GabrielBarbosaUFSC/Projeto-Pendular/AnaliseDados/Motor Torque/Motor Ref/- AliExpress_files/12V24VDC-Low-Speed-Long-Life-Super-Powerful-Torque-42mm-Planetary-Gearbox-Gears-775-Motor-Planet-Deceleration.jpg_220x220xz.jpg_.webp

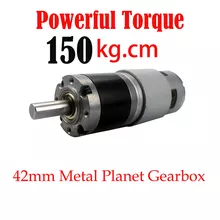
AnaliseDados/Motor Torque/Motor Ref/- AliExpress_files/12V24VDC-Low-Speed-Long-Life-Super-Powerful-Torque-42mm-Planetary-Gearbox-Gears-775-Motor-Planet-Deceleration.jpg_220x220xz.jpg_.webp
