GabrielBarbosaUFSC/Projeto-Pendular/AnaliseDados/Motor Torque/Motor Ref/- AliExpress_files/S8b12bd6959954953b04f11af4f3a7155e.jpg

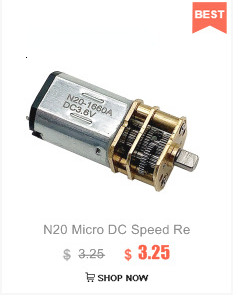
AnaliseDados/Motor Torque/Motor Ref/- AliExpress_files/S8b12bd6959954953b04f11af4f3a7155e.jpg
