GabrielBarbosaUFSC/Projeto-Pendular/AnaliseDados/MotorExp/Exp4/readme.txt

Objetivo: obter a constante de velocidade do motor, constante de torque e constante de atrito
