GabrielBarbosaUFSC/Projeto-Pendular/Trabalho_SNL_2023.pdf

# Análise da Dinâmica e Estratégia de Controle via Realimentação Linearizante para um Robô Autoequilibrado de Duas Rodas

Luan Diego Ramalho Arantes
Mestrado em Engenharia de Automação e Sistemas Sistemas Não Lineares
Florianópolis, Brasil
luandrarantes@gmail.com

Resumo—Robôs autoequilibrados de duas rodas são sistemas não lineares e naturalmente instáveis que demandam técnicas avançadas de controle para garantir sua estabilidade e rastreamento de trajetórias de forma eficaz. No contexto deste estudo, a dinâmica do robô foi cuidadosamente analisada para entender o comportamento de seus pontos de equilíbrio. Com base nessa análise, a modelagem e o controle do robô autoequilibrado foram detalhados. Utilizando a abordagem de linearização por realimentação, o sistema foi desacoplado e foram derivados subsistemas que foram posteriormente controlados. O principal objetivo era desenvolver controladores que permitissem um rastreamento eficaz de trajetórias, considerando trajetórias em formato de quadrado e círculo como estudos de caso. Através da técnica de regulador quadrático linear, os ganhos dos controladores foram otimizados para garantir um rastreamento preciso e uma resposta rápida. Os resultados simulados, comparando as trajetórias desejadas com as obtidas, confirmaram a eficácia dos controladores projetados.
Index Terms—Linearização por realimentação, Rastreamento de trajetória, Robô autoequilibrado
I. INTRODUÇÃO

O controle por realimentação, reconhecido como parte fundamental e intrínseca a uma gama de situações e a base da engenharia de controle de sistemas, este conceito é este presente em inúmeros sistemas dinâmicos, desde o equilíbrio e a locomoção de bípedes até a aterrissagem autônoma de foguetes. Embora os métodos de controle tradicionais sejam adequados para sistemas simples, sistemas mais complexos, como robôs com múltiplos eixos de movimento, plantas químicas complexas e redes elétricas avançadas, exigem abordagens mais sofisticadas. Estes sistemas apresentam desafios devido às suas complexas interações e aos impactos que um parâmetro pode ter em outro .
Os robôs autoequilibrados representam uma classe de sistemas complexos que operam sob o princípio de manter o equilíbrio enquanto realizam movimentos em superfícies variadas. Estes robôs, frequentemente equipados com duas rodas, empregam técnicas avançadas de controle para permanecerem eretos e navegarem em ambientes complexos. O estudo de tais sistemas é crucial, não apenas devido à sua relevância na pesquisa robótica atual, mas também devido às suas potenciais aplicações em áreas como transporte pessoal, logística e assistência a mobilidade.
Um dos desafios centrais na operação destes robôs é a necessidade de controladores precisos e robustos. O controlador deve garantir não apenas que o robô se mantenha equilibrado, mas também que seja capaz de seguir trajetórias predeterminadas em diferentes cenários. O seguimento de trajetória é uma habilidade vital para muitas aplicações práticas, permitindo que o robô execute tarefas de maneira autônoma e eficiente. Neste contexto, o presente trabalho visa desenvolver um controlador para um robô autoequilibrado de duas rodas, focando no seguimento de trajetória. O estudo aborda a modelagem do sistema, o desenvolvimento do controlador e a simulação de seu desempenho em duas diferentes trajetórias. As metodologias e resultados aqui apresentados oferecem uma perspectiva técnica e detalhada sobre os desafios e soluções associados ao controle de robôs autoequilibrados.

II. DESENVOLVIMENTO

Nesta seção, é abordada a modelagem detalhada do robô autoequilibrado, proporcionando uma base sólida para compreensão do sistema e seu comportamento. A representação em espaço de estados é utilizada como principal ferramenta para capturar a dinâmica intrínseca do robô. Em sequência, é realizado um estudo aprofundado da dinâmica do sistema, explorando os pontos de equilíbrio e o comportamento sob variações de parâmetros. Concluindo esta seção, o projeto do controlador é elaborado com base nas informações coletadas, visando um desempenho otimizado no seguimento de trajetórias.

A. Modelagem do Sistema
Um robô autoequilibrado é caracterizado por duas rodas acopladas a uma estrutura vertical, tendo seu comportamento análogo a um pêndulo invertido fixado a um carrinho. Dado o interesse em modelar o movimento do robô em duas dimensões (x e y), dois ângulos se tornam fundamentais para a descrição do sistema: o ângulo de inclinação θ, que representa o desvio da estrutura vertical em relação ao eixo z, e o ângulo de guinada α, que descreve a rotação do robô em torno do

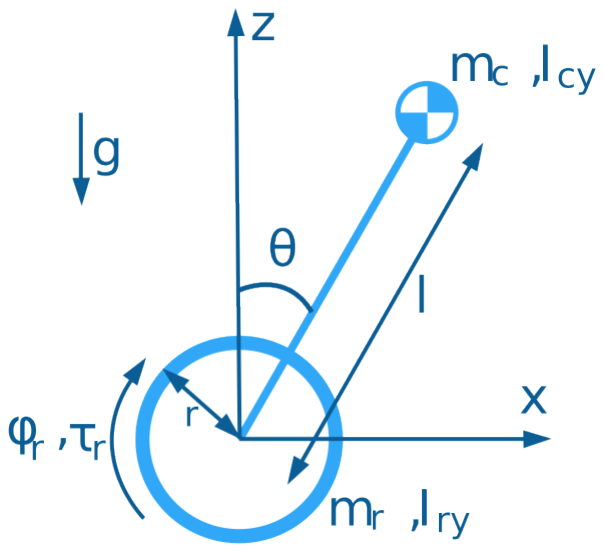
[picture p3: figure]
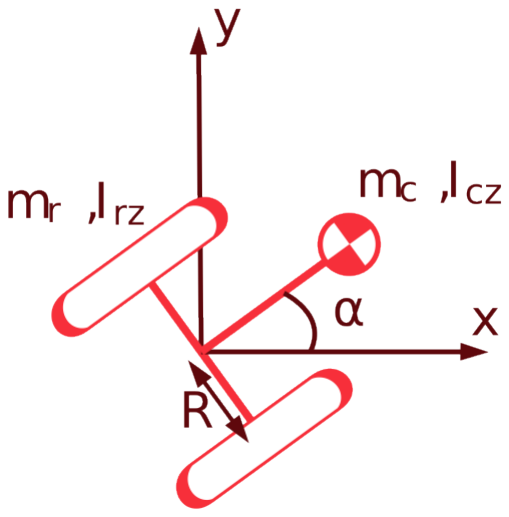
[picture p4: figure]

(a) Vista lateral. | (b) Vista superior.

Figura 1. Diagramas de corpo livre.

eixo z. A Figura 1a apresenta o diagrama de corpo livre do robô quando visto de lado (eixos x e z), enquanto a Figura 1b fornece uma perspectiva superior, mostrando o diagrama de corpo livre em relação aos eixos x e y.
As variáveis representadas nos diagramas têm os seguintes significados:
- mc: Massa do centro de massa do robô.
- mr: Massa da roda.
- Icy e Icz: Momentos de inércia do corpo em torno dos eixos y e z, respectivamente.
- Iry e Irz: Momentos de inércia da roda em torno dos eixos y e z, respectivamente.
- φr: Ângulo de rotação da roda.
- τr: Torque aplicado à roda.
- l: Distância entre o centro da roda e o centro de massa do robô.
- r: Raio da roda.
- R: Distância entre o centro do eixo do robô e a roda.
- g: Aceleração devido à gravidade.
A representação em espaço de estados para o sistema pode ser obtida utilizando as equações de Euler-Lagrange. Este método aproveita a análise da energia cinética e potencial do sistema para estabelecer as equações de movimento. A equação de Euler-Lagrange é dada por:

d

dt
∂L
∂q˙i
−

∂L
∂qi
= Qi | (1)

Onde qi representa as coordenadas generalizadas e Qi são as forças não conservativas. O Lagrangiano L é definido como a diferença entre a energia cinética T e a energia potencial U:

L = T − U | (2)

É importante destacar que neste sistema ocorrem perdas devido a fatores não ideais, como o atrito. A função de dissipação de Rayleigh é uma ferramenta que pode ser utilizada para incluir estas perdas nas equações de movimento. Esta função representa a perda de energia associada ao atrito proporcional à velocidade, neste caso, do atrito entre a roda e o solo. A expressão para essa função é:

F =

br
2

( ˙φ

2
r1 + ˙φ

2
r2
) | (3)

Onde br é o coeficiente de atrito viscoso e φ˙ r1 e φ˙ r2 são as velocidades angulares das rodas.
A equação de Euler-Lagrange modificada, que leva em conta a dissipação causada pelo atrito, torna-se:

d

dt
∂L
∂q˙i
−

∂L
∂qi

= Qi −

∂F
∂q˙i

(4)

O robô pode ser conceptualmente dividido em duas partes principais: o centro de massa e as rodas. As energias associadas a cada uma dessas partes são descritas por:
Centro de Massa:

Tc =

mcv

2
c
2

+

Icyθ

2
2

+

Iczα

2
2

(5)

Uc = mcgl cos(θ) | (6)

Rodas:

Tr =

mr(v

2
r1 + v

2
r2

)
2

+

Iry( ˙φ

2
r1 + ˙φ

2
r2

)
2

+ Irzα˙

2
(7)
Ur = 0 | (8)

Onde vc,vr1 e vr2 são as velocidades totais do centro de massa, da roda 1 e da roda 2 nos eixos x, y e z.
Considerando que não existe deslizamento, a relação entre a velocidade linear vri e a velocidade angular φ˙ i das rodas é dada por:
vri = rφ˙ i | com i = 1, 2 | (9)

A velocidade do corpo do robô vc pode ser reescrita em função da velocidade horizontal do corpo vxy e da velocidade vertical do corpo z˙c:

vc =

q
| v
| 2 xy + ˙z
| 2 c | (10)

Como o corpo está preso à roda logo:

vxy =

vr1 + vr2
2
| + l
| ˙θ cos θ | (11)

z˙c = −l

˙θ sin θ | (12)

Por se tratar de um robô com rotação diferencial:
α˙ = | vr2 − vr1
| 2R | (13)

Com base em (2) e nas equações de (5) a (13):

L = aφ˙

2
r + bφ˙

2
rm +

c
2

( ˙φ

2
r1 + ˙φ

2
r2

)

+ dφ˙ r

˙θ cos θ +

e
2

˙θ
2 − mcgl cos θ (14)

Com:

φr = φr1 + φr2 | φrm = φr2 − φr1

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
| Icz
2

+ Irz

c = mrr

2 + Iry | d = mcrl
| 2
e = 2mcl
2 + Icy | f = mcgl

As coordenadas generalizadas qi e suas respectivas forças Qi para o sistema são definidas como:

qi

: φr1, φr2, θ | (15)
Qi
: τr1, τr2, −(τr1 + τr2) | (16)

Considerando que as rodas são controlados por motores de corrente continua, o torque gerado pelas rodas pode ser expresso como:

τri = KVi − B

φ˙ ri − ˙θ
com i = 1, 2 (17)

Resolvendo a equação (4) para as coordenadas apresentadas em (15), resulta em:

∆

φ¨r1
φ¨r2
¨θ
- + A = Bu
V1
V2
(18)

∆ =

a | b | d cos(θ)
b | a | d cos(θ)
d cos(θ) d cos(θ) | c
- (19)

A =

(br + B) ˙φr1 − B ˙θ − d sin(θ)

˙θ
2
(br + B) ˙φr2 − B ˙θ − d sin(θ)

˙θ
2
2B ˙θ − B( ˙φr1 + ˙φr2) − e sin(θ)
- (20)

Bu =

K | 0
0 | K
−K −K
- (21)

Resultando no espaço de estados:

x˙ =

### 0 I

0 0
x +
0 0

### 0 Ω (x)

+
0
Ψ (x)
u (22)

Onde:

x =

φr1 | φr2 | θ φ˙ r1 | φ˙ r2

˙θ

⊺

Ω (x) = −∆⁻¹A
Ψ (x) = ∆⁻¹Bu

u =

V1 V2

⊺

Os parâmetros físicos do sistema foram determinados a partir de um modelo real, que pode ser visto em [6]. Estes valores foram obtidos combinando técnicas de medição direta com simulações para alcançar aproximações que se assemelham às características reais do objeto de estudo. A Tabela 1 apresenta estes parâmetros:

Par. | Valor | Par. | Valor
r | 0.04 m | R | 0.18 m
Icz | 2.567 · 10⁻³ kg · m² | mc | 1.013 kg
mr | 0.07 kg | Iry | 7.103 · 10⁻⁵ kg · m²
Irz | 4.256 · 10⁻⁵ kg · m² | l | 0.09 m
Icy | 1.866 · 10⁻² kg · m² | g | 9.806 m/s²
br | 0.03 kg · m²/s | B | 0.05573
K | 0.2109
Tabela I
PARÂMETROS FÍSICOS DO SISTEMA.
B. Estudo da Dinâmica do Sistema
Com a equação de movimento do sistema já derivada, o próximo passo consiste em analisar seu comportamento dinâmico. Nesta subseção, focaremos inicialmente na análise dos pontos de equilíbrio do sistema. Posteriormente, estudaremos como o sistema responde às variações na ação de controle e no coeficiente de atrito.
Dado que as equações do sistema são independentes do ângulo da roda e dependem apenas da velocidade da roda, a análise pode se concentrar em situações onde a velocidade da roda não é nula. Resolvendo a equação (18) para condições onde as acelerações φ¨r1, φ¨r2,

¨θ e a velocidade ˙θ são nulas e com tensões nos motores constantes, obtemos:

φ˙ r1 = −

KV1
B + br

(23)

φ˙ r2 = −

KV2
B + br

(24)

θ = arcsin
K
e

(V1 + V2)

1 −

B
B + br

(25)

A partir das propriedades da função arcoseno, deduzimos as seguintes possibilidades para os equilíbrios:
- Se V1 +V2 = 0, o sistema possui apenas dois equilíbrios, onde ¯θ ∈ {0, π}.
- Se V1 + V2 = ±

e
K(1− B
B+br

)

, o sistema possui um único equilíbrio em ¯θ ∈ {±π
2

}.
- Para 0 < |V1+V2| <

e
K(1− B
B+br

)

, existem dois equilíbrios para ¯θ em dois ângulos complementares dependentes de V1 + V2.
- Se |V1 + V2| >

e
K(1− B
B+br

)

, o sistema não possui pontos de equilíbrio.
A complexidade do sistema dificulta a análise algébrica da estabilidade dos seus pontos de equilíbrio. No entanto, ao empregar ferramentas computacionais como MATLAB e XPPAUT, conclui-se que os pontos de equilíbrio em −

π
2 ≤
¯θ ≤
π
2

são estáveis, enquanto os pontos em −

π

2 < ¯θ < π
2
são instáveis. É crucial ressaltar que, no contexto real do sistema, ângulos maiores que π
2

ou menores que −

π
2

não
são fisicamente possíveis, implicando que todos os pontos de equilíbrios fisicamente possíveis são instáveis.
A fim de aprofundar a compreensão sobre a dinâmica do sistema e como os pontos de equilíbrio são influenciados por determinados parâmetros, foram gerados gráficos de bifurcação utilizando a ferramenta XPPAUT. Os parâmetros escolhidos para essa análise, o coeficiente de atrito br e as tensões no motor, foram selecionados devido à possibilidade de variação destes durante a operação do robô.
O impacto nos pontos de equilíbrio não é determinado isoladamente pelos valores das tensões, mas pela soma delas. Portanto, o foco dessa seção será a variação do V1 e do br, já que a variação de V2 gera o mesmo resultado. A Figura 2a ilustra a evolução dos pontos de equilíbrio conforme V1 aumenta para diferentes valores de br, enquanto a Figura 2b mostra como os pontos de equilíbrio evoluem à medida que

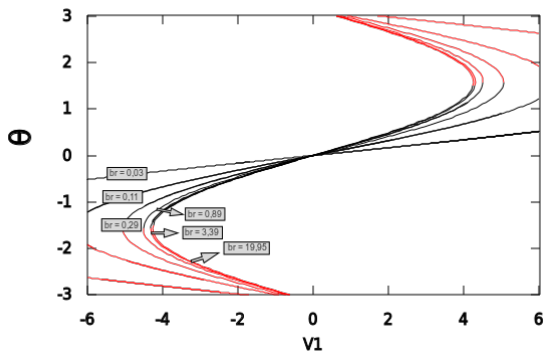
[picture p5: figure]

(a) θ em função de V1.

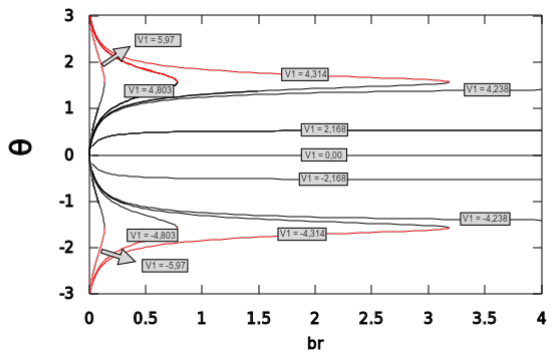
[picture p6: figure]

(b) θ em função de br.

Figura 2. Diagramas de Bifurcação. As linhas pretas e vermelhas simbolizam respectivamente que o ponto de equilíbrio é instável ou estavel.

br aumenta para vários valores de V1. A faixa de estudo para as tensões foi estabelecida entre −6V e 6V , considerando que esses são os limites fornecidos pelo motor utilizado no sistema real.
Ao analisar os gráficos, observa-se que à medida que o valor de br aumenta, a região contendo os pontos de equilíbrio diminui. Esta tendência é resultado da expressão 1 −

B
B+br
presente em (25). No entanto, existe um ponto de saturação para essa relação: quando br tende ao infinito, ¯θ converge para arcsin K
e

(V1 + V2)

C. Projeto do Controlador
Após uma análise minuciosa e entendimento do comportamento do sistema, a próxima etapa é formular uma lei de controle adequada, denotada por u, para o sistema em questão. Esta seção visa detalhar o processo de criação e desenvolvimento do controlador.
O principal intuito deste projeto de controle é desenvolver uma lei que possibilite ao sistema seguir uma trajetória específica. Em outras palavras, o sistema deve ser capaz de rastrear referências para os ângulos das rodas. Contudo, dada a natureza intrinsecamente instável do sistema, o controle também deve assegurar a estabilidade do ângulo θ, buscando minimizar ao máximo suas variações. Com esse objetivo em vista, optou-se pelo uso da técnica de linearização por realimentação, o que viabiliza o desacoplamento do sistema e sua análise em partes separadas. É relevante mencionar, no entanto, que devido à subatuação do sistema, apenas uma linearização parcial é praticável.
Primeiramente, realizou-se uma mudança de variáveis, uma vez que, na configuração atual do sistema, não é possível realizar o seu desacoplamento por meio da linearização por realimentação, isto é devido ao angulo de inclinação θ depender de ambas as velocidades angulares φ˙ ri. As novas variáveis definidas foram:
φr1 = φr − φrm | (26)
φr2 = φr + φrm | (27)

Esta transformação de variáveis conduziu a um novo espaço de estados representado por:

x˙ n =

### 0 I

0 0
xn +
0 0

### 0 Ωn (xn)

+
0
Ψn (xn)
u (28)

Onde:

xn =

φr | φrm | θ φ˙ r | φ˙ rm

˙θ

⊺

Ωn (x) = −∆⁻¹
n An
Ψn (x) = ∆⁻¹
| n Bu
u =
V1 V2

⊺

∆n =

(a + b)/2 (b − a)/2 d cos(θ) (a + b)/2 (b − a)/2 d cos(θ)
d cos(θ) | 0 | c

An =

(br + B)( ˙φr − φ˙ rm) − B ˙θ − d sin(θ)

˙θ
2
(br + B)( ˙φr + ˙φrm) − B ˙θ − d sin(θ)

˙θ
2
2B ˙θ − Bφ˙ r − e sin(θ)

Se segmentarmos o sistema em partes atuadas x2 e não atuadas x1, obtemos:

x˙ 1 = x2 | (29)
x˙ 2 = Ωn (x) + Ψn (x)u | (30)

O vetor x2 engloba φ˙ r e φ˙ rm. O objetivo da linearização é que o sistema resultante seja representado por:

φ¨r = v1 | (31)
φ¨rm = v2 | (32)

Para atingir este objetivo, podemos decompor x˙ 2 da seguinte forma:
φ¨r

φ¨rm
= Ωn1 (x) + Ψn1 (x)u | (33)
¨θ = Ωn2 (x) + Ψn2 (x)u | (34)

Onde Ωn1 e Ωn2 são submatrizes de Ωn, e Ψn1 e Ψn2 são submatrizes de Ψn.
Ao igualar -

φ¨r φ¨rm⊺
a
v1 v2

⊺
, obtemos a ação de
controle linearizante para o sistema:

u = Ψ⁻¹
n1

(x)

v1
v2
− Ωn1 (x)
(35)

Ao implementar esta ação de controle no sistema, resultamos em dois sistemas desacoplados. O primeiro é descrito por:

y˙1 =

φ˙ r
˙θ
v1
L + Mv1

(36)

Onde

L =

2d sin(θ)

˙θ
2 − brφ˙ r + e sin(θ)
c + 2d cos(θ)

M = −

a + b + d cos(θ)
c + 2d cos(θ)

O segundo sistema é descrito por:

y˙2 =

φ˙ rm
v2
(37)

O primeiro sistema foi parcialmente linearizado, de forma que o comportamento do sistema ainda é dependente dos estados θ e

˙θ. Analisando os pontos de equilíbrio, é observado um comportamento similar ao do sistema completo. Fazendo as mesmas considerações de que o ângulo da roda não influencia diretamente no sistema, obtemos um ponto de equilíbrio localizado em:

y¯1 =

φr
φ˙ r
arcsin brφ˙ r
0

(38)

Sendo que todos os pontos de equilíbrio com −π/2 < θ < π/2 são instáveis. Portanto, ainda é necessário projetar outra forma de controle para estabilizar o sistema. No entanto, observe que a linearização por realimentação reduz significativamente a complexidade do sistema, e que o segundo sistema está completamente desacoplado.
Para projetar o controlador, o sistema é linearizado no ponto de equilíbrio y¯1 = [0, 0, 0, 0]⊺
, pois o objetivo é fazer com que o robô siga uma trajetória de um ponto a outro, mantendo o ângulo θ com a mínima variação possível. O sistema resultante é:
y˙1 = A1y1 + B1v1 | (39)

A2 =

0 | 0 | 1 | 0
0 | 0 | 0 | 1
0 | 0 | 0 | 0
0 | e
c+2d | −
| | br c+2d | 0

(40)

B2 =

0
0
1
−

a+b+d
c+2d

(41)

Devido à ausência de um integrador no sistema, ele apresentará erro em estado permanente para o ângulo φm. Para corrigir isso, um integrador é incluído no sistema:

˙ζ1 = (ref1 − φr). | (42)

A lei de controle v1 foi então definida como:

v1 = Kc1

ref1 − φr
−θ
˙ref1 − φ˙ r
− ˙θ
ζ1

(43)

A determinação do ganho Kc1 foi realizada utilizando a técnica ótima do regulador quadrático linear, definindo as matrizes Q e R como:

Q = diag (100, 0, 0, 0, 10) | (44)
R = 0.001. | (45)

O objetivo foi dar máxima prioridade ao controle do posicionamento do robô, buscando uma resposta rápida que mantenha o sistema estável.
Para o segundo sistema, o controle foi estabelecido através da dinâmica do erro. A dinâmica do erro é dada por:

e˙2 = A2e2 + B2(ref ¨
2 − v2) | (46)

Onde:

A2 =

0 1

0 0
B2 =
0
1

e2 =

ref2 − φrm

˙ref2 − φ˙ rm⊺

Mais uma vez, para assegurar um erro nulo em regime permanente, um integrador foi acrescentado. Isso resultou na seguinte lei de controle:

v2 = ref ¨
2 + Kc2
e2
ζ2
(47)

A determinação do ganho Kc2 foi realizada também empregando o regulador quadrático linear. As matrizes Q e R foram definidas da seguinte forma:

Q = diag (10, 0, 10) | (48)
R = 0.001 | (49)

O foco principal, mais uma vez, foi assegurar um desempenho otimizado para o erro de posicionamento em relação à referência
Com o controlador agora estabelecido e definido, a próxima seção se dedica a apresentar e discutir os resultados obtidos quando este controle é aplicado ao sistema para buscando o seguimento de trajetória, oferecendo uma visão concreta de sua eficácia.

III. RESULTADOS

Nesta seção, serão apresentados e discutidos os resultados obtidos com a aplicação dos controladores desenvolvidos no sistema em estudo. O foco está no desempenho do sistema em seguir trajetórias específicas de um ponto a outro no plano x − y.
Para realizar o seguimento de trajetória é crucial compreender as equações de cinemática inversa associadas ao robô de duas rodas. As relações entre as posições x e y, o ângulo de guinada α, e os estados do sistema são dados por:

x˙ =

r cos(θ) ˙φr
2

(50)

y˙ =

r sin(θ) ˙φr
2

(51)

α˙ =

rφ˙ rm
2R

(52)

Através delas é possível derivar as equações para a cinemática inversa:

φ˙ r =

2 ˙x
r cos(θ)

=

2 ˙y
r sin(θ)

(53)

φ˙ rm =

2Rα˙
r

(54)

É importante notar que quando sin(θ) = 0, a equação em função de y˙ não pode ser aplicada. Similarmente, para cos(θ) = 0, a equação em função de x˙ é inválida. Utilizando a cinemática inversa é possível, mediante uma dada trajetória no eixo x−y, determinar a referência para os estados do sistema. Para o rastreamento da trajetória entre dois pontos foi utilizado a representação por um polinômio de terceiro grau:

xref = x0 +

3
t

2
f

(xf − x0)t

2 −

2
t

3
f

(xf − x0)t

3
(55)

Onde xref representa a referência, x0 o ponto inicial, xf o ponto final, e tf o tempo de deslocamento. Cada referencial de posição (x,y e α) são representados por um polinômio neste formato.
Utilizando o Simulink foi desenvolvido uma simulação compreensiva do sistema. Essa simulação engloba a planta não linear, um gerador de trajetória, o cálculo das ações de controle v1 e v2, e da realimentação linearizante.
Na validação do controlador proposto, duas trajetórias paradigmáticas foram escolhidas: uma em formato de quadrado e outra em formato circular. A escolha dessas trajetórias se dá pela sua capacidade de, conjuntamente, testar diversas facetas do desempenho do robô e do controlador em situações distintas.
Estas trajetórias foram geradas através do polinômio de terceiro grau mencionado anteriormente. Em cada caso, foram definidos pontos-chave para guiar o robô através da trajetória desejada, aproveitando o gerador de trajetória desenvolvido no Simulink.
A. Trajetória em Formato de Quadrado
A Figura 3 apresenta uma comparação entre a trajetória de referência, que era esperada, e a trajetória efetivamente obtida durante a simulação. Fica claro que existem pequenas variações durante o trajeto, entretanto o robô consegue seguir a referência e chegar até o ponto desejado.
A Figura 4 se concentra nos estados do sistema. Através dela, pode-se observar que o estado desacoplado durante a linearização por realimentação apresenta erro praticamente nulo durante toda a trajetória, enquanto o restante apresenta pequenas variações, mas alcançam a referência de forma satisfatória com pequenas variações no ângulo θ.

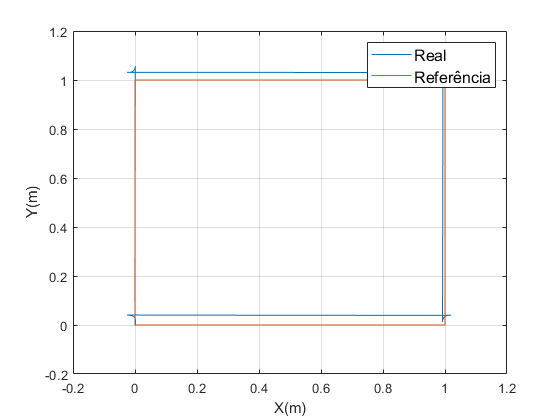
[picture p7: figure]

Figura 3. Comparação entre a trajetória de referência e o resultado da simulação para o formato quadrado.

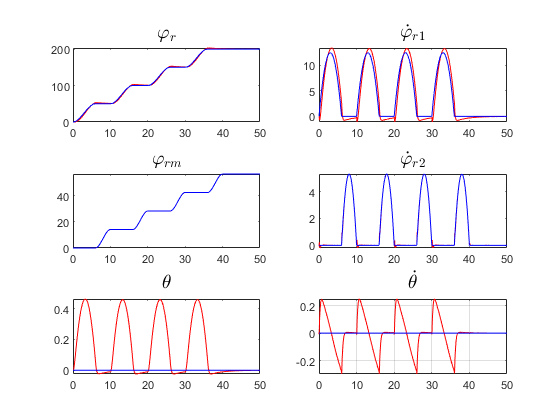
[picture p8: figure]

Figura 4. Estados do sistema para a trajetória em quadrado. Onde as linhas azuis e vermelhas simbolizam o resultado simulado e a referência.

B. Trajetória em Formato de Círculo
A Figura 5 compara a trajetória de referência com a trajetória efetivamente obtida durante a simulação para o círculo. Perceba que como o seguimento é feito de ponto a ponto, a referência tem um formato de hexágono que acaba resultando em um círculo.
A Figura 6 se aprofunda na análise dos estados do sistema. Nela, observa-se a evolução dos estados do robô ao longo da sua movimentação circular, e a comparação destes com suas respectivas referências dá uma visão clara sobre a eficiência do controlador, reafirmando os resultados obtidos com a trajetória quadrada.

IV. CONCLUSÃO
Ao longo deste estudo, foi realizada uma análise profunda da modelagem, controle e simulação de um robô autoequilibrado de duas rodas, ilustrando a importância da precisão em

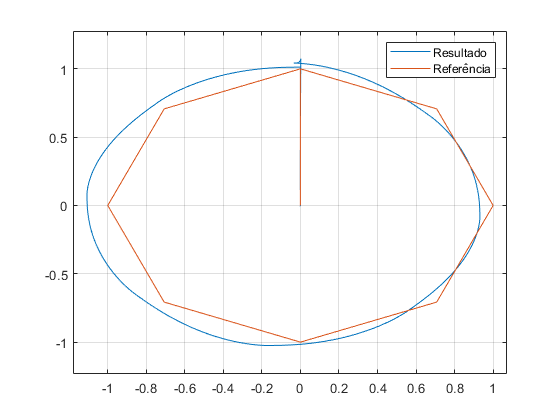
[picture p9: figure]

Figura 5. Comparação entre a trajetória de referência e o resultado da simulação para o formato circular.

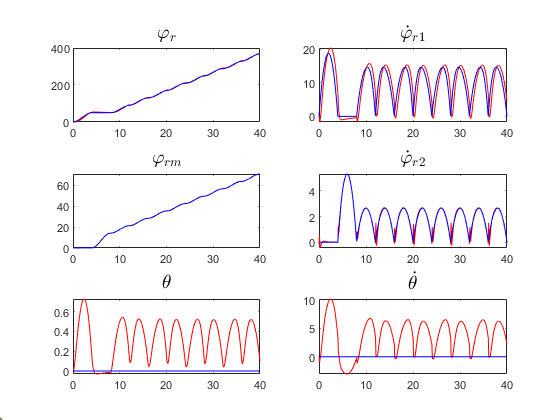
[picture p10: figure]

Figura 6. Estados do sistema para a trajetória em círculo. Onde as linhas azuis e vermelhas simbolizam o resultado simulado e a referência.

cada etapa do processo. O controle realimentado linearizante demonstrou ser uma abordagem eficaz na estabilização do sistema e no seguimento de trajetórias predeterminadas, mesmo em situações de complexidade, como trajetórias em formas de quadrado e círculo.
A modelagem inicial, que contou com parâmetros físicos extraídos de um modelo real, estabeleceu uma base sólida para o desenvolvimento subsequente. As trajetórias de referência, alinhadas com as equações de cinemática inversa, forneceram um roteiro para o deslocamento desejado do robô. Os resultados das simulações, ao serem comparados com as trajetórias de referência, evidenciaram o desempenho do controle implementado.
No entanto, é importante destacar que, embora os resultados tenham sido promissores, sistemas reais podem apresentar variações devido a ruídos, desgastes e outras perturbações não consideradas neste estudo. Portanto, testes em um ambiente real e ajustes contínuos do controlador podem ser necessários para otimizar ainda mais o desempenho do robô. Concluindo, este estudo representa um passo significativo na compreensão e controle de robôs de duas rodas. A abordagem adotada pode servir como um modelo para futuras investigações e implementações em sistemas robóticos similares.

REFERÊNCIAS

[1] B. Friedland, Control system design: an introduction to state-space methods. New York: Courier Corporation, 2012.
[2] G.F. Franklin et al, Feedback control of dynamic systems, 7th ed. Harlow: Pearson Education Limited, 2015.
[3] N.S. Nise, Control systems engineering, 7th ed. Pomona: John Wiley & Sons, 2015.
[4] R.C. Bishop and R.H. Dorf, Modern control systems, 14th ed. Harlow: Pearson Education Limited, 2022.
[5] K. Ogata, Modern Control Engineering, 5th ed. Upper Saddle River: Prentice Hall, 2010.
[6] L. D. R. Arantes and J. C. B. Dalcin, "Implementação de controle de realimentação de estados ótimo com observador de ordem mínima em um robô auto-equilibrado,"B.S. Thesis, Instituto Federal Catarinense, São Bento do Sul, Brazil, 2022. https://pergamumweb.ifc.edu.br/pergamumweb_ifc/vinculos/000026/00002628.pdf. (Accessed: Jun. 20, 2023).
[7] I. Gandarilla, J. Montoya-Cháirez, V. Santibáñez, C. Aguilar-Avelar, and
J. Moreno-Valenzuela, “Trajectory tracking control of a self-balancing robot via adaptive neural networks,” Engineering Science and Technology, an International Journal, vol. 35, pp. 101259, 2022.
[8] R. C. Ooi, “Balancing a two-wheeled autonomous robot,” B.S. Thesis, Faculty of Eng. & Math. Sciences, Univ. of Western Australia, Perth, Nedlands, 2003.
[9] K. Peng, X. Ruan, and G. Zuo, “Dynamic model and balancing control for two-wheeled self-balancing mobile robot on the slopes,” in Proceedings of the 10th World Congress on Intelligent Control and Automation, 2012, pp. 3681-3685.
[10] H. -S. Juang and K. -Y. Lum, "Design and control of a two-wheel self-balancing robot using the arduino microcontroller board,"2013 10th IEEE International Conference on Control and Automation (ICCA), Hangzhou, China, 2013, pp. 634-639, doi: 10.1109/ICCA.2013.6565146.
[11] A. Wasif, D. Raza, W. Rasheed, Z. Farooq and S. Q. Ali, "Design and implementation of a two wheel self balancing robot with a two level adaptive control,"Eighth International Conference on Digital Information Management (ICDIM 2013), Islamabad, Pakistan, 2013, pp. 187-193, doi: 10.1109/ICDIM.2013.6694021.
