GabrielBarbosaUFSC/Projeto-Pendular/AnaliseDados/Motor Torque/Motor Ref/- AliExpress_files/32GP-31ZY-Miniature-Planetary-Reducer-Diameter-DC-12V-24V-Reducer-Motor-Low-Speed-Speed-Regulation-Large.jpg_220x220xz.jpg_.webp

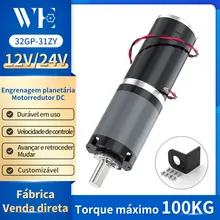
AnaliseDados/Motor Torque/Motor Ref/- AliExpress_files/32GP-31ZY-Miniature-Planetary-Reducer-Diameter-DC-12V-24V-Reducer-Motor-Low-Speed-Speed-Regulation-Large.jpg_220x220xz.jpg_.webp
