GabrielBarbosaUFSC/Projeto-Pendular/AnaliseDados/Motor Torque/Motor Ref/- AliExpress_files/38-tubular-motor-with-mounting-bracket-12V-24V-DC-motor-mounting-bracket.jpg_220x220xz.jpg_.webp

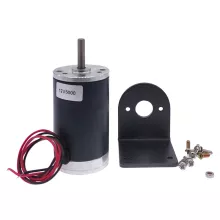
AnaliseDados/Motor Torque/Motor Ref/- AliExpress_files/38-tubular-motor-with-mounting-bracket-12V-24V-DC-motor-mounting-bracket.jpg_220x220xz.jpg_.webp
