GabrielBarbosaUFSC/Projeto-Pendular/AnaliseDados/Motor Torque/Motor Ref/- AliExpress_files/42GP-775-Metal-Planetary-Geared-DC-Geared-Motor-DC-12V-24V-1600RPM-8RPM-High-Torque-and.jpg_220x220xz.jpg_.webp

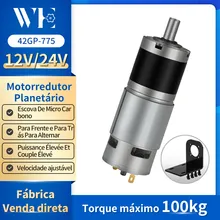
AnaliseDados/Motor Torque/Motor Ref/- AliExpress_files/42GP-775-Metal-Planetary-Geared-DC-Geared-Motor-DC-12V-24V-1600RPM-8RPM-High-Torque-and.jpg_220x220xz.jpg_.webp
