GabrielBarbosaUFSC/Projeto-Pendular/AnaliseDados/Motor Torque/Motor Ref/- AliExpress_files/3700x3700.png

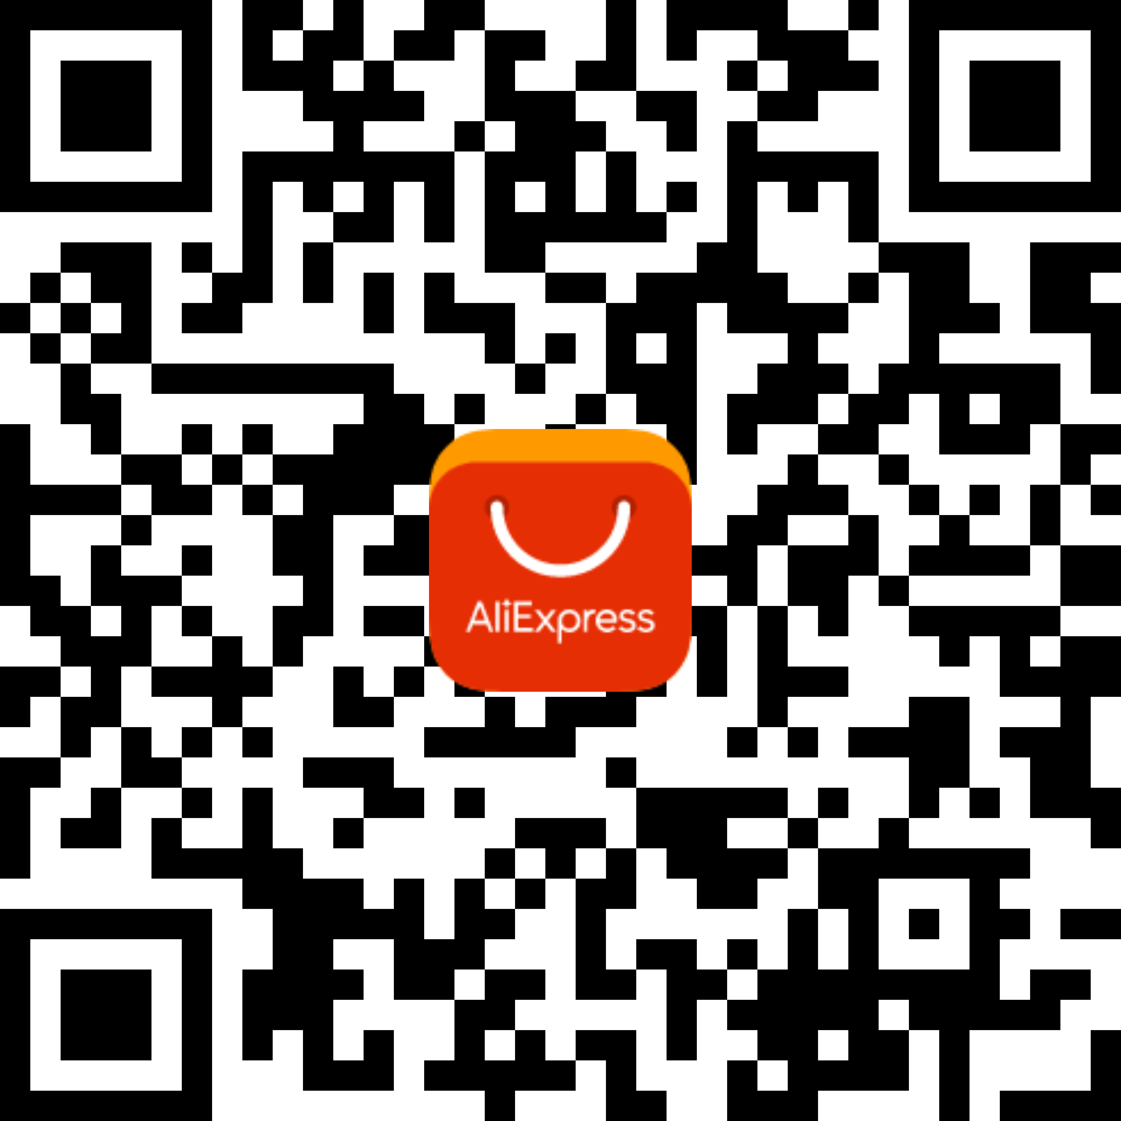
AnaliseDados/Motor Torque/Motor Ref/- AliExpress_files/3700x3700.png
