GabrielBarbosaUFSC/Projeto-Pendular/AnaliseDados/Motor Torque/Motor Ref/- AliExpress_files/Acf9686770d4548f88235293f16f73d94Y.jpg_220x220.jpg

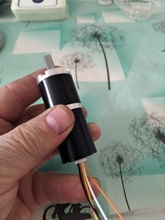
AnaliseDados/Motor Torque/Motor Ref/- AliExpress_files/Acf9686770d4548f88235293f16f73d94Y.jpg_220x220.jpg
