GabrielBarbosaUFSC/Projeto-Pendular/AnaliseDados/Motor Torque/Motor Ref/- AliExpress_files/JGA25-370DG-high-speed-smliar-planetary-gear-reductor-higher-torque-6v-12v-electric-dc-motor-speed.jpg_220x220xz.jpg_.webp

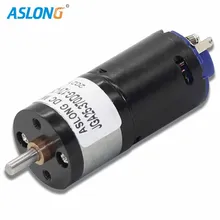
AnaliseDados/Motor Torque/Motor Ref/- AliExpress_files/JGA25-370DG-high-speed-smliar-planetary-gear-reductor-higher-torque-6v-12v-electric-dc-motor-speed.jpg_220x220xz.jpg_.webp
