GabrielBarbosaUFSC/Projeto-Pendular/AnaliseDados/Motor Torque/Motor Ref/- AliExpress_files/Motor-DC-sem-escova-com-redu-o-planet-ria-grande-torque-longa-vida-ajust-vel-velocidade.jpg_220x220.jpg_(4).webp

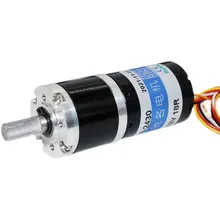
AnaliseDados/Motor Torque/Motor Ref/- AliExpress_files/Motor-DC-sem-escova-com-redu-o-planet-ria-grande-torque-longa-vida-ajust-vel-velocidade.jpg_220x220.jpg_(4).webp
