GabrielBarbosaUFSC/Projeto-Pendular/AnaliseDados/Motor Torque/Motor Ref/- AliExpress_files/S2fa1220719c643399ce4d512a5ea91bdv.jpg

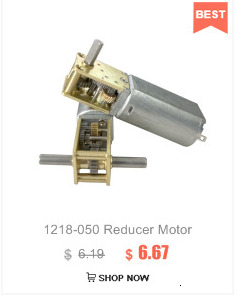
AnaliseDados/Motor Torque/Motor Ref/- AliExpress_files/S2fa1220719c643399ce4d512a5ea91bdv.jpg
