GabrielBarbosaUFSC/Projeto-Pendular/AnaliseDados/Motor Torque/Motor Ref/- AliExpress_files/S6e2927d535a24a8dab750e9eafaf82ff7.jpg

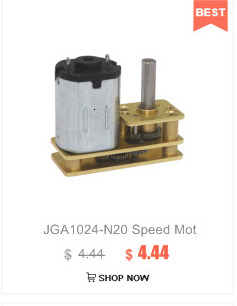
AnaliseDados/Motor Torque/Motor Ref/- AliExpress_files/S6e2927d535a24a8dab750e9eafaf82ff7.jpg
