GabrielBarbosaUFSC/Projeto-Pendular/AnaliseDados/Motor Torque/Motor Ref/- AliExpress_files/S07cfcc3f5e8d4fb99c3cf1406d75d274F.jpg

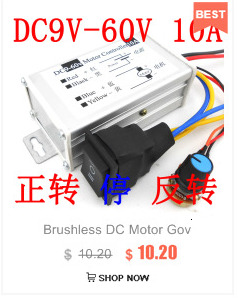
AnaliseDados/Motor Torque/Motor Ref/- AliExpress_files/S07cfcc3f5e8d4fb99c3cf1406d75d274F.jpg
