GabrielBarbosaUFSC/Projeto-Pendular/AnaliseDados/Motor Torque/Motor Ref/- AliExpress_files/S50b93c0f01454846a10f5cffa283654cB.jpg

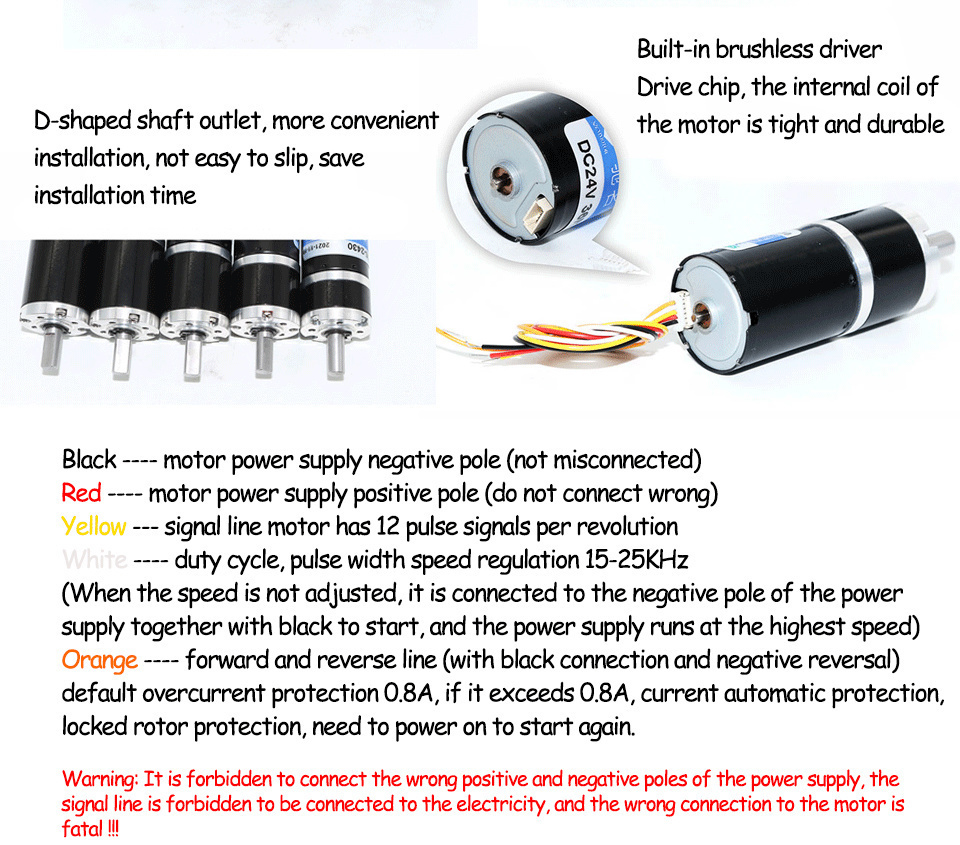
AnaliseDados/Motor Torque/Motor Ref/- AliExpress_files/S50b93c0f01454846a10f5cffa283654cB.jpg
