GabrielBarbosaUFSC/Projeto-Pendular/AnaliseDados/Motor Torque/Motor Ref/- AliExpress_files/S628f2d3af4b74cb694f8d91f3ad29bdfO.jpg

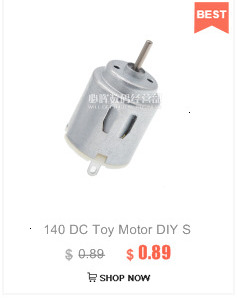
AnaliseDados/Motor Torque/Motor Ref/- AliExpress_files/S628f2d3af4b74cb694f8d91f3ad29bdfO.jpg
