GabrielBarbosaUFSC/Projeto-Pendular/AnaliseDados/Motor Torque/Motor Ref/- AliExpress_files/S769e7251c33f43f1a88d88708e3894b1C.jpg

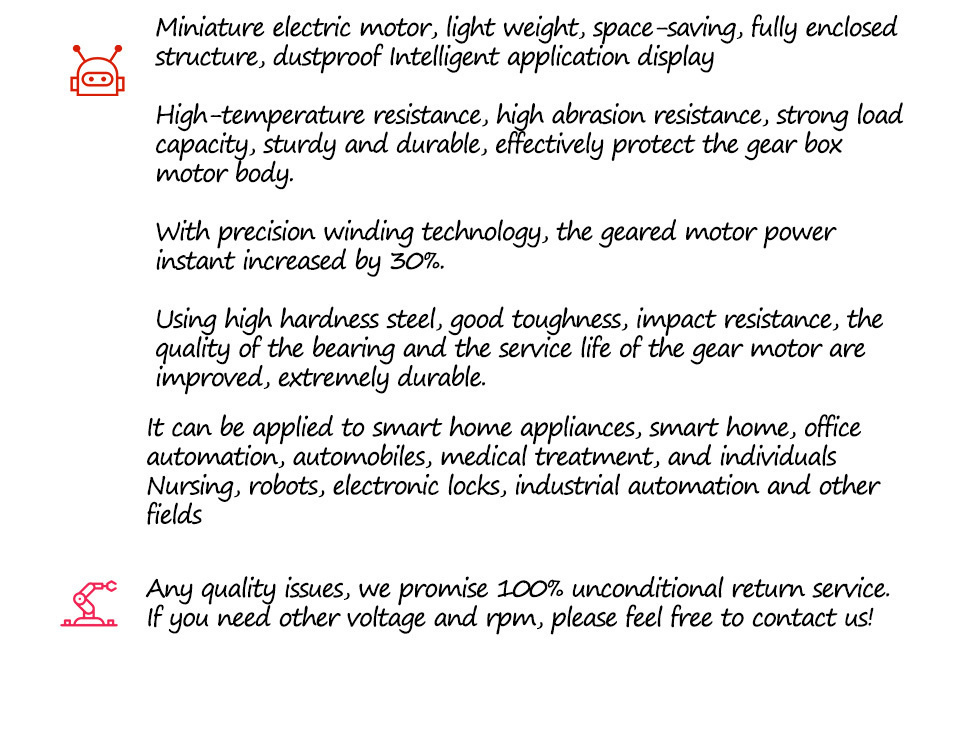
AnaliseDados/Motor Torque/Motor Ref/- AliExpress_files/S769e7251c33f43f1a88d88708e3894b1C.jpg
