GabrielBarbosaUFSC/Projeto-Pendular/AnaliseDados/Motor Torque/Motor Ref/- AliExpress_files/S53218644f4d64fdf8c5e7e89ed7189e5h.jpg

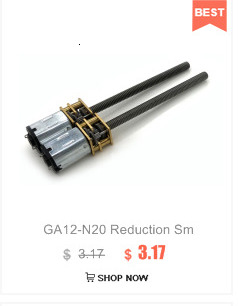
AnaliseDados/Motor Torque/Motor Ref/- AliExpress_files/S53218644f4d64fdf8c5e7e89ed7189e5h.jpg
