GabrielBarbosaUFSC/Projeto-Pendular/AnaliseDados/Motor Torque/Motor Ref/- AliExpress_files/Sb840779ef0e5463ca49472092bf7551bi.jpg

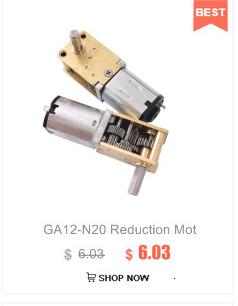
AnaliseDados/Motor Torque/Motor Ref/- AliExpress_files/Sb840779ef0e5463ca49472092bf7551bi.jpg
