GabrielBarbosaUFSC/Projeto-Pendular/AnaliseDados/Motor Torque/Motor Ref/- AliExpress_files/Sc5a4d05cd8c94926beddb98914d14ed8e.jpg

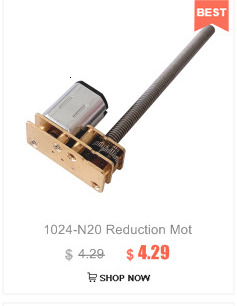
AnaliseDados/Motor Torque/Motor Ref/- AliExpress_files/Sc5a4d05cd8c94926beddb98914d14ed8e.jpg
