GabrielBarbosaUFSC/Projeto-Pendular/AnaliseDados/Motor Torque/Motor Ref/- AliExpress_files/Sdc4eb58b0e0b4e018221f7dcb24357b3Y.jpg

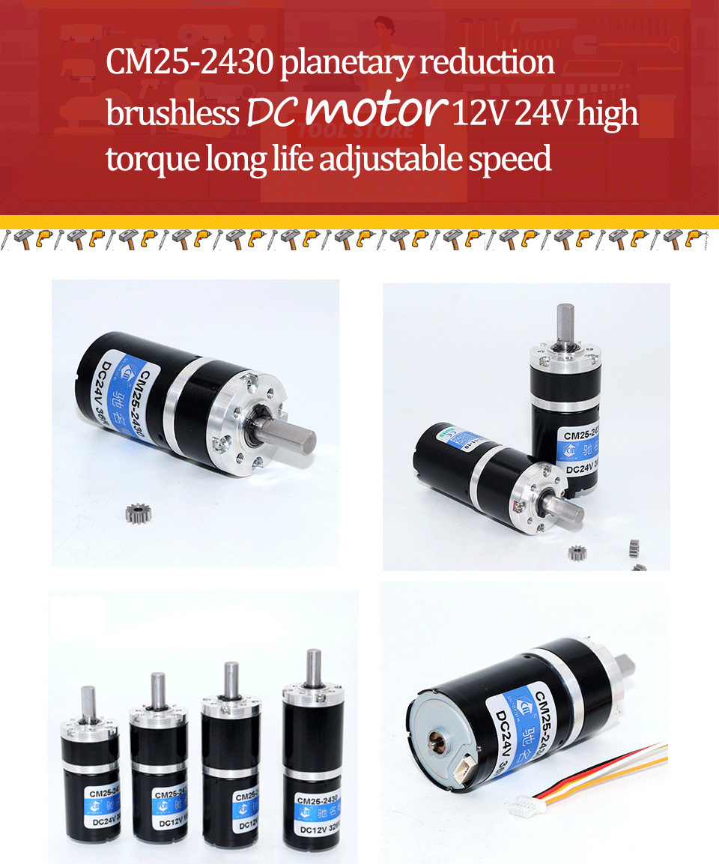
AnaliseDados/Motor Torque/Motor Ref/- AliExpress_files/Sdc4eb58b0e0b4e018221f7dcb24357b3Y.jpg
