GabrielBarbosaUFSC/Projeto-Pendular/AnaliseDados/Motor Torque/Motor Ref/- AliExpress_files/Se4b58b5161fe40a8be9bee0f4715ef393.jpg

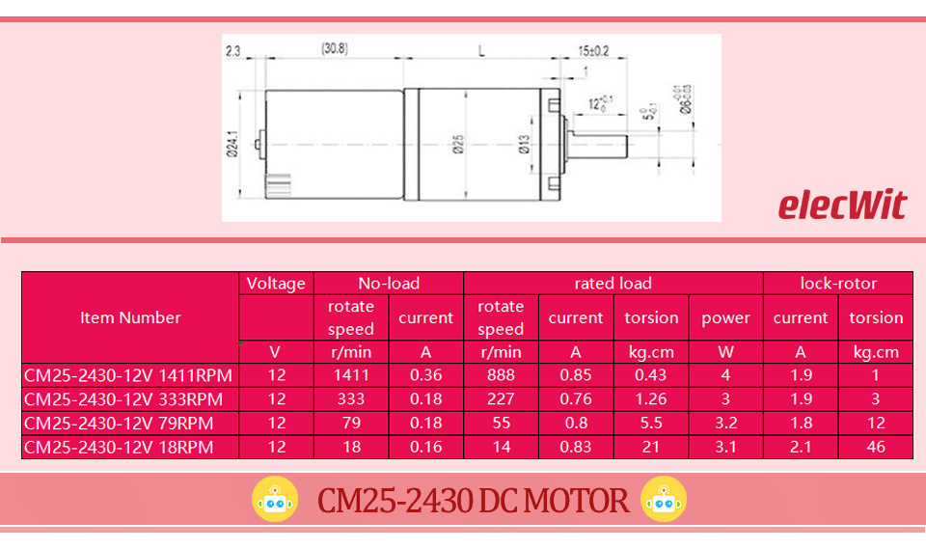
AnaliseDados/Motor Torque/Motor Ref/- AliExpress_files/Se4b58b5161fe40a8be9bee0f4715ef393.jpg
