GabrielBarbosaUFSC/Projeto-Pendular/AnaliseDados/Motor Torque/Motor Ref/- AliExpress_files/Sfef4784510ad4d8d91afd1b74cc17bfaw.jpg

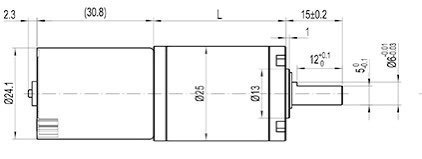
AnaliseDados/Motor Torque/Motor Ref/- AliExpress_files/Sfef4784510ad4d8d91afd1b74cc17bfaw.jpg
