GabrielBarbosaUFSC/Projeto-Pendular/AnaliseDados/Motor Torque/Motor Ref/- AliExpress_files/Stepper-Motor-42-motor-Extruder-Gear-Nema17-Stepper-Motor-17HS4401S-PG-Ratio-5-18-1-Planetary.jpg_220x220xz.jpg_.webp

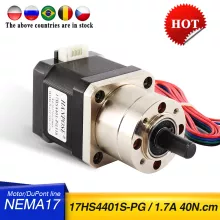
AnaliseDados/Motor Torque/Motor Ref/- AliExpress_files/Stepper-Motor-42-motor-Extruder-Gear-Nema17-Stepper-Motor-17HS4401S-PG-Ratio-5-18-1-Planetary.jpg_220x220xz.jpg_.webp
