GabrielBarbosaUFSC/Projeto-Pendular/CAD/CAD Final/Bateria/Mod Bat.SLDASM

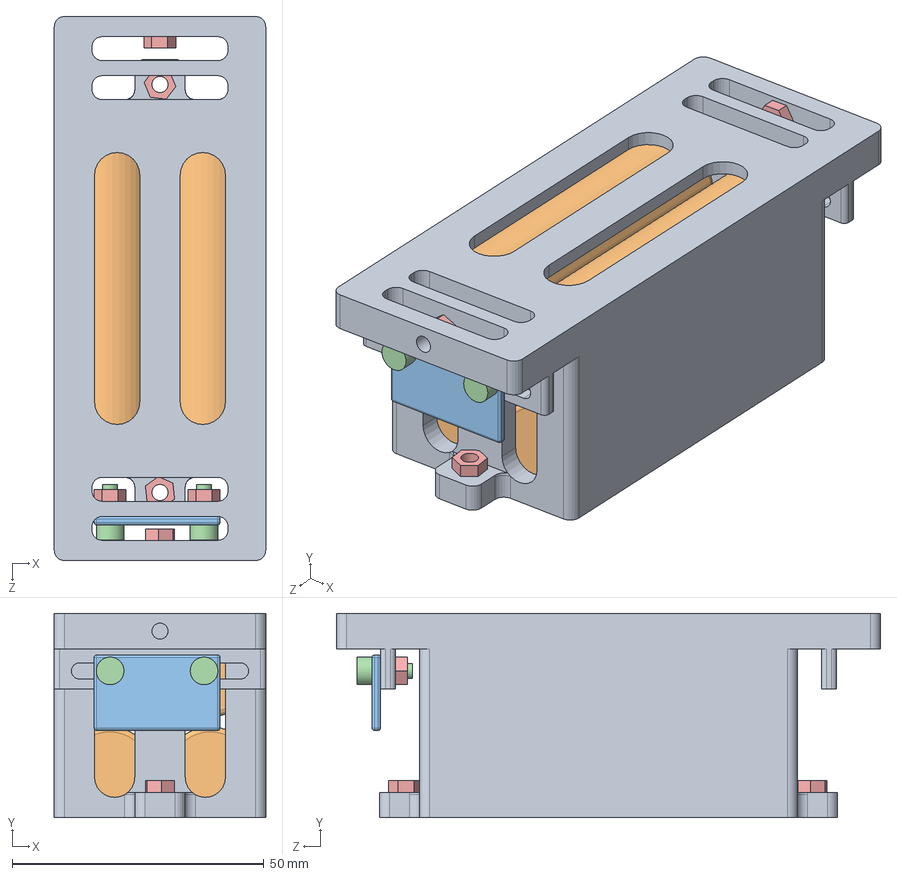
[picture p35: CAD file, 2023-08-23]
CAD/CAD Final/Bateria/Mod Bat.SLDASM
42.0 x 40.5 x 108.0 mm
Base
Baterry x 4
MPU9250
8M3 x 2
porca x 6
