GabrielBarbosaUFSC/Projeto-Pendular/CAD/CAD Final/Controlador/Mod Ctrl.SLDASM

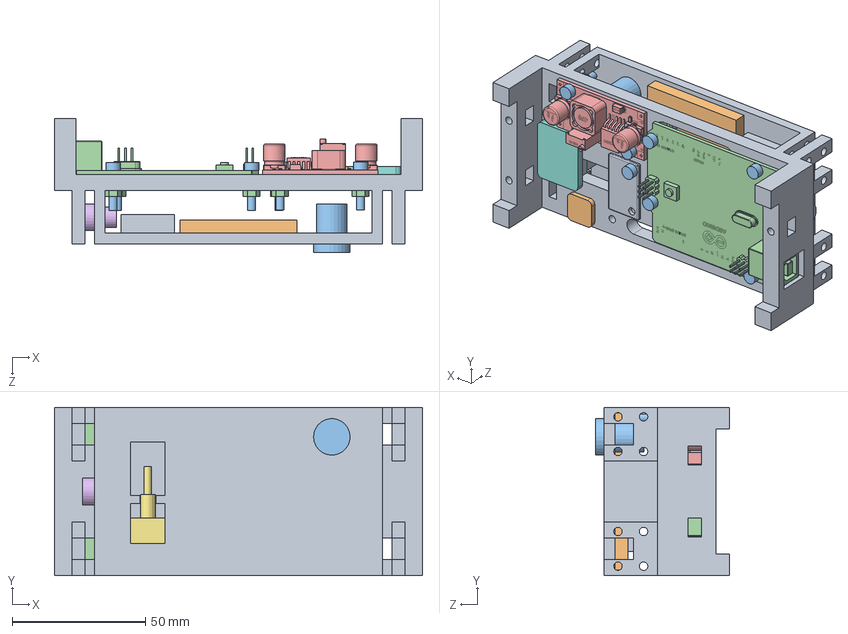
[picture p36: CAD file, 2023-08-23]
CAD/CAD Final/Controlador/Mod Ctrl.SLDASM
138.0 x 63.0 x 50.2 mm
BaseControllers
BMS
button
esp_uno
LM2596
p4
switch
LedsCtrl
MPU9250
divisor
15M3 x 7
porca x 7
