GabrielBarbosaUFSC/Projeto-Pendular/CAD/CAD Final/Pendular.SLDASM

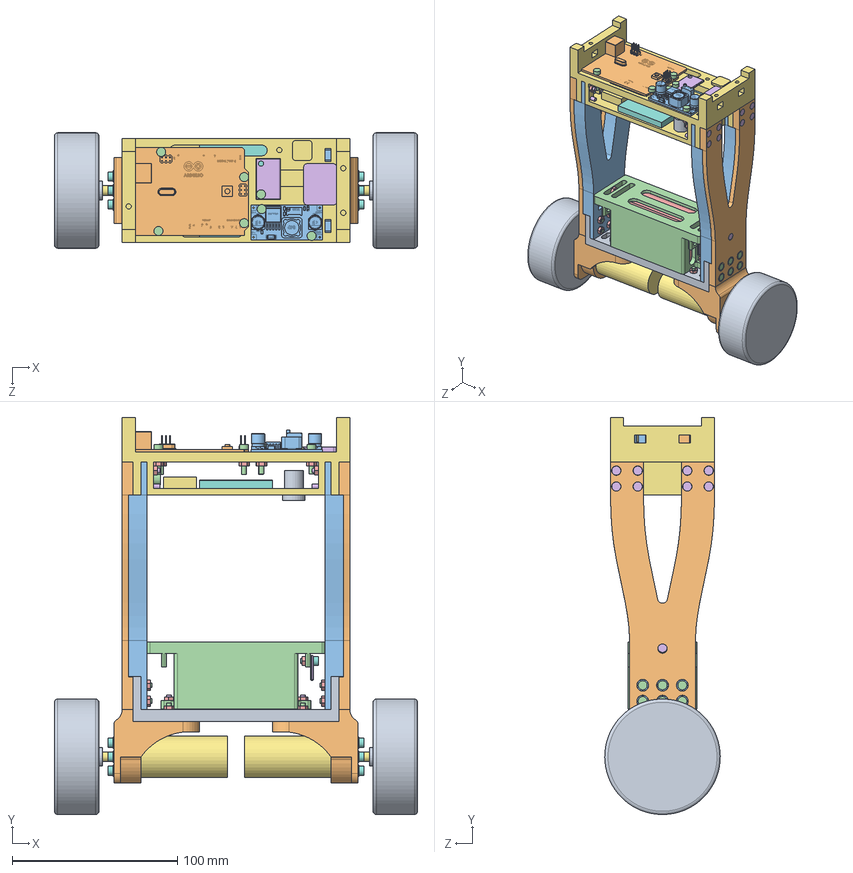
[picture p37: CAD file, 2023-08-23]
CAD/CAD Final/Pendular.SLDASM
220.0 x 240.5 x 70.0 mm
motorsuportebase
motorsuporte x 2
Arruela x 26
15M3 x 23
porca x 33
20M3 x 20
motor x 2
8M3 x 10
roda x 2
EstruturaLateral2a x 2
EstruturaLateral2b x 2
Base
Baterry x 4
MPU9250 x 2
BaseControllers
BMS
button
esp_uno
LM2596
p4
switch
LedsCtrl
divisor
