GabrielBarbosaUFSC/Projeto-Pendular/CAD/Motor Module/MotorSuporte/MontSuppMotor.SLDASM

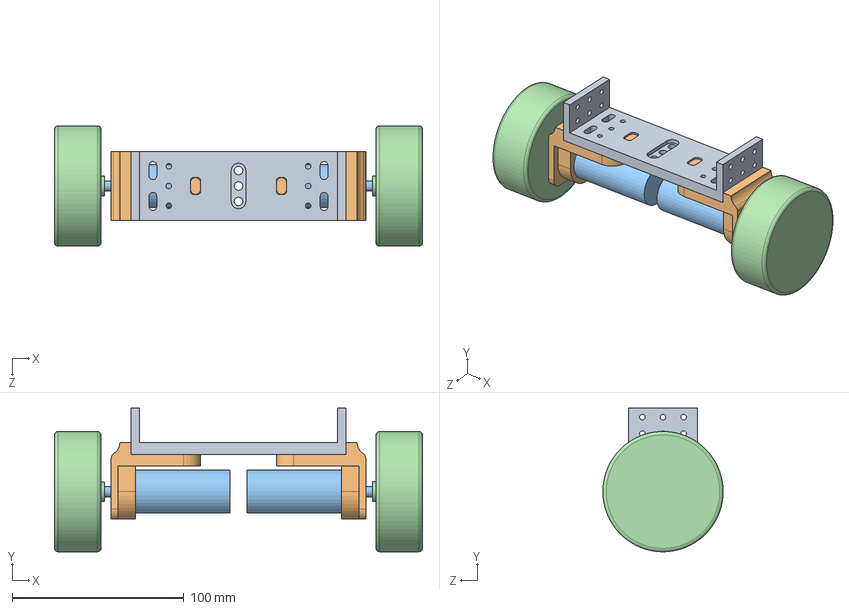
[picture p38: CAD file, 2023-06-04]
CAD/Motor Module/MotorSuporte/MontSuppMotor.SLDASM
214.0 x 83.5 x 70.0 mm
motorsuportebase
motorsuporte x 2
motor x 2
roda x 2
