GabrielBarbosaUFSC/Projeto-Pendular/CAD/Pendular2.SLDASM

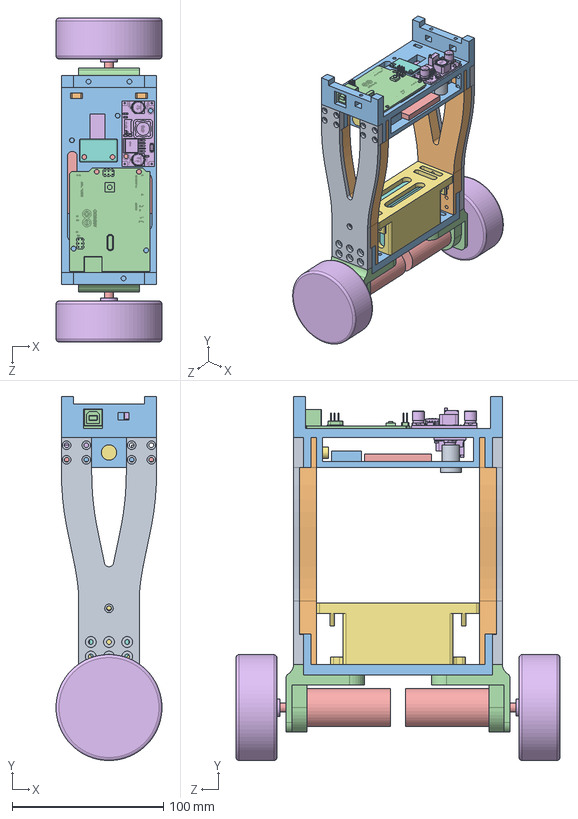
[picture p39: CAD file, 2023-06-04]
CAD/Pendular2.SLDASM
70.0 x 240.5 x 214.0 mm
EstruturaLateral2a x 2
EstruturaLateral2b x 2
BaseControllers
esp_uno
LM2596 x 2
MPU9250
motorsuportebase
motorsuporte x 2
motor x 2
roda x 2
Base
Baterry x 4
