GabrielBarbosaUFSC/Projeto-Pendular/GabrielCAD/BatteryModule/BatteryModule.SLDASM

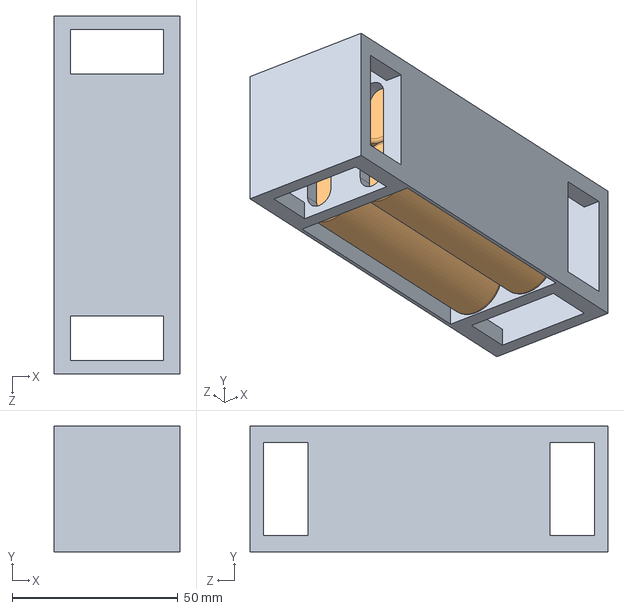
[picture p40: CAD file, 2023-05-04]
GabrielCAD/BatteryModule/BatteryModule.SLDASM
38.0 x 38.0 x 108.0 mm
Base
Baterry x 4
