GabrielBarbosaUFSC/Projeto-Pendular/GabrielCAD/Motor Module/MotorModule.SLDASM

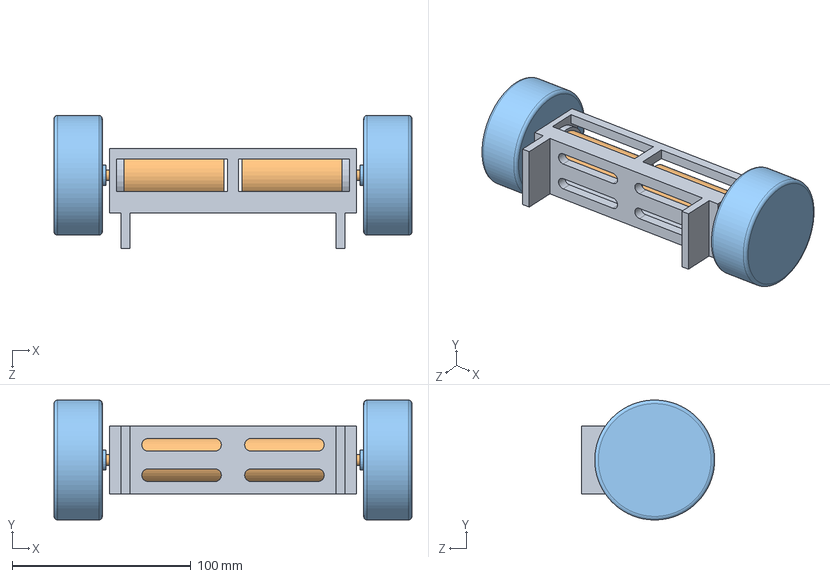
[picture p41: CAD file, 2023-05-04]
GabrielCAD/Motor Module/MotorModule.SLDASM
200.0 x 67.0 x 74.5 mm
motor_base
motor x 2
roda x 2
