GabrielBarbosaUFSC/Projeto-Pendular/CAD/BatteryModule/BatteryModule.SLDASM

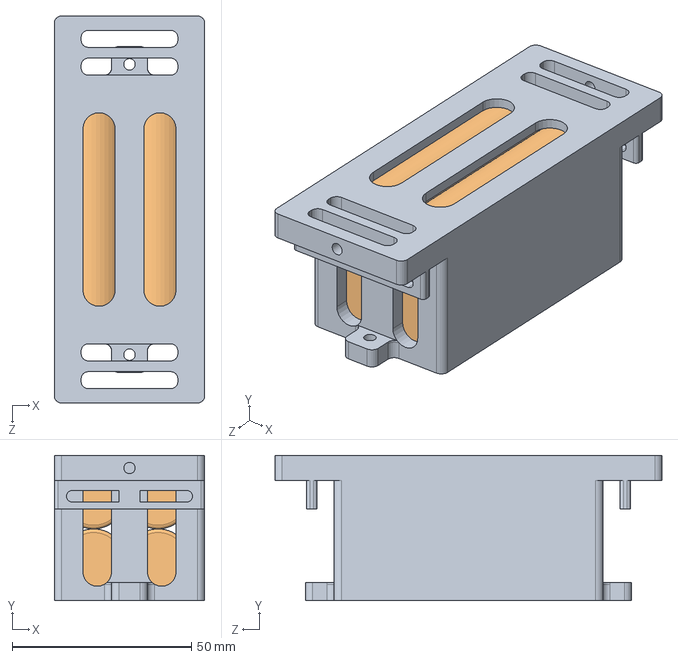
[picture p42: CAD file, 2023-06-13]
CAD/BatteryModule/BatteryModule.SLDASM
42.0 x 40.5 x 108.0 mm
Base
Baterry x 4
