GabrielBarbosaUFSC/Projeto-Pendular/CAD/ControllerModule/MontTop.SLDASM

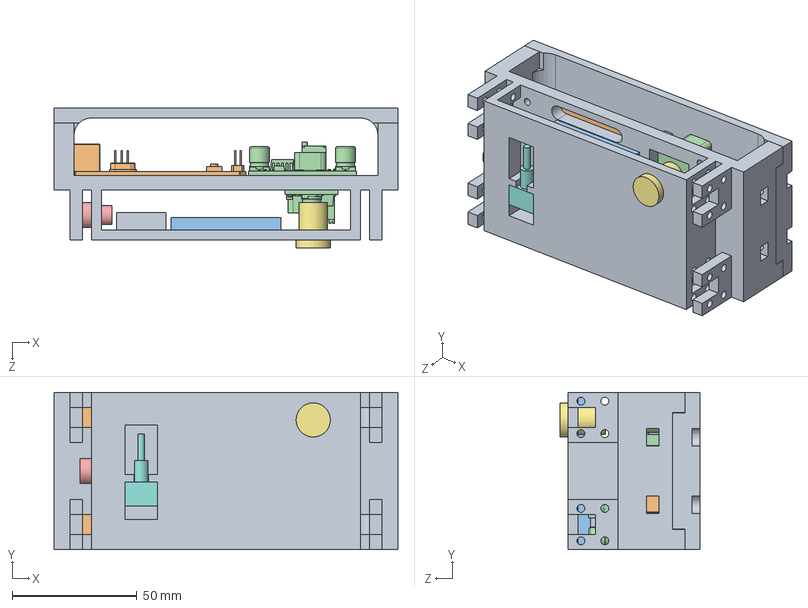
[picture p43: CAD file, 2023-08-02]
CAD/ControllerModule/MontTop.SLDASM
138.0 x 63.0 x 56.2 mm
BaseControllers
esp_uno
LM2596 x 2
MPU9250
Topoo
