GabrielBarbosaUFSC/Projeto-Pendular/CAD/Suporte Motor/Montagem1.SLDASM

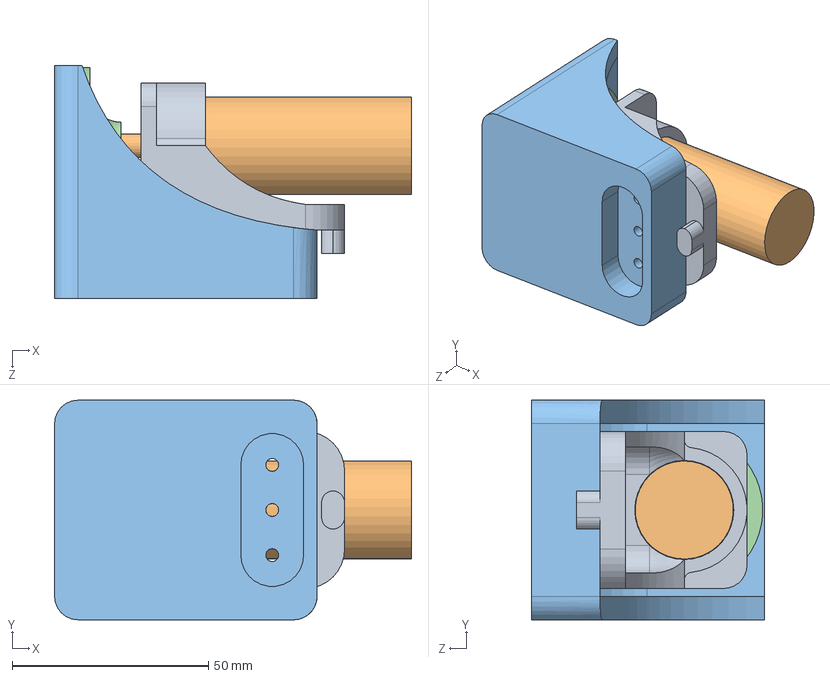
[picture p44: CAD file, 2023-07-24]
CAD/Suporte Motor/Montagem1.SLDASM
91.0 x 56.0 x 59.5 mm
motorsuporte
motor
juncao
arruela
