GabrielBarbosaUFSC/Projeto-Pendular/CAD/Trava Motor 2/Montagem1.SLDASM

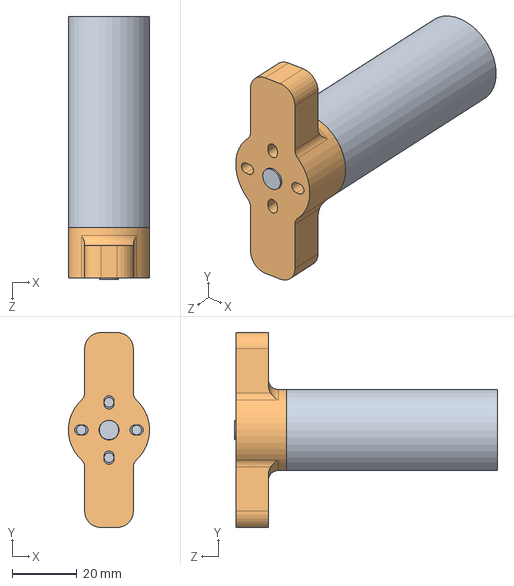
[picture p45: CAD file, 2023-07-18]
CAD/Trava Motor 2/Montagem1.SLDASM
25.0 x 60.0 x 81.0 mm
motor
Trava
