GabrielBarbosaUFSC/Projeto-Pendular/CAD/CAD Final/Suporte Lateral/Mont Lat.SLDASM

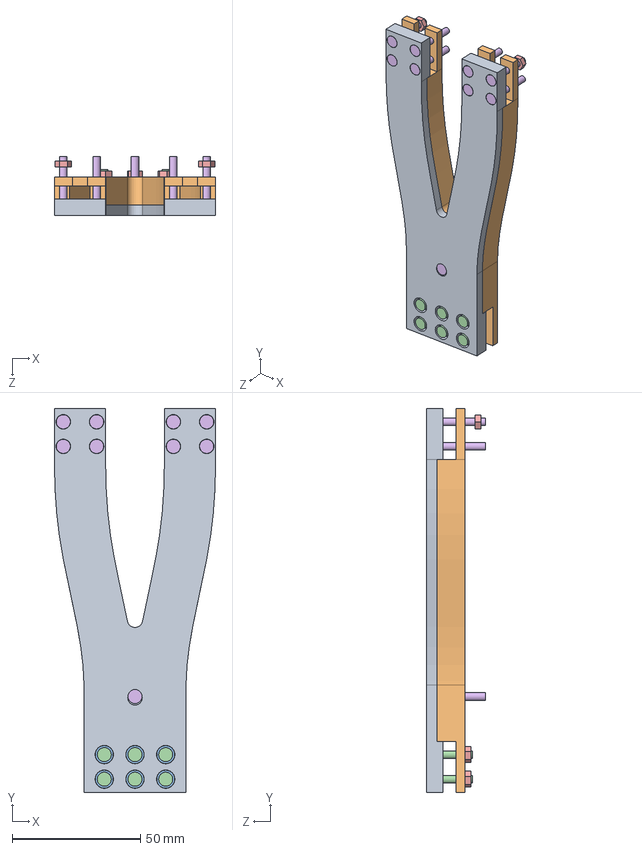
[picture p46: CAD file, 2023-08-23]
CAD/CAD Final/Suporte Lateral/Mont Lat.SLDASM
63.0 x 150.0 x 23.0 mm
EstruturaLateral2a
EstruturaLateral2b
Arruela x 6
15M3 x 6
porca x 8
20M3 x 9
