GabrielBarbosaUFSC/Projeto-Pendular/CAD/Motor Module/MotorModule.SLDASM

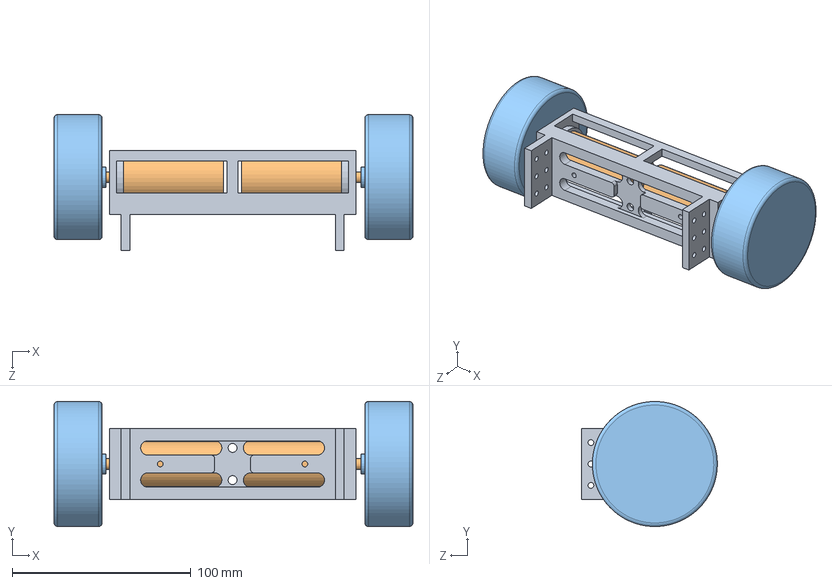
[picture p47: CAD file, 2023-06-04]
CAD/Motor Module/MotorModule.SLDASM
201.0 x 70.0 x 76.0 mm
motor_base
motor x 2
roda x 2
