GabrielBarbosaUFSC/Projeto-Pendular/CAD/CAD Final/Motores/Mont Motor.SLDASM

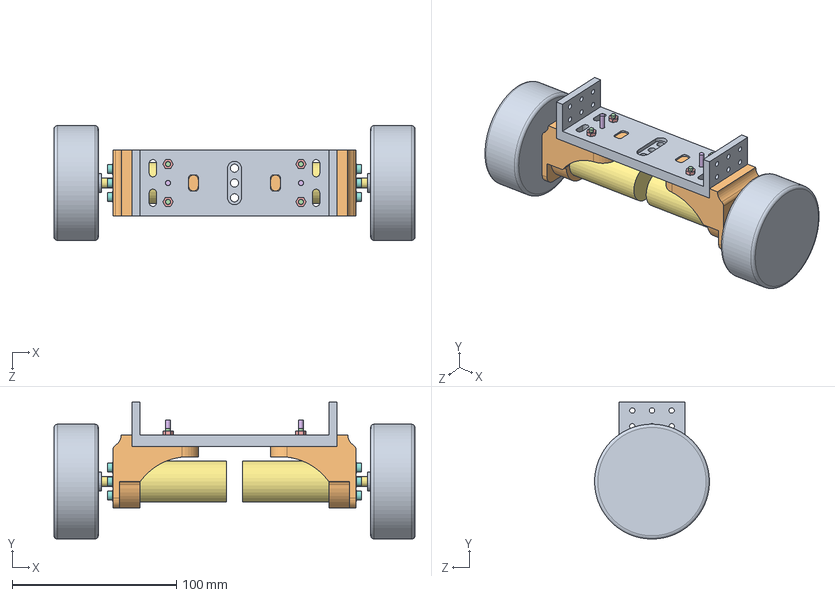
[picture p48: CAD file, 2023-08-23]
CAD/CAD Final/Motores/Mont Motor.SLDASM
220.0 x 83.5 x 70.0 mm
motorsuportebase
motorsuporte x 2
Arruela x 14
15M3 x 4
porca x 4
20M3 x 2
motor x 2
8M3 x 8
roda x 2
