GabrielBarbosaUFSC/Projeto-Pendular/CAD/ControllerModule/MontCapa.SLDASM

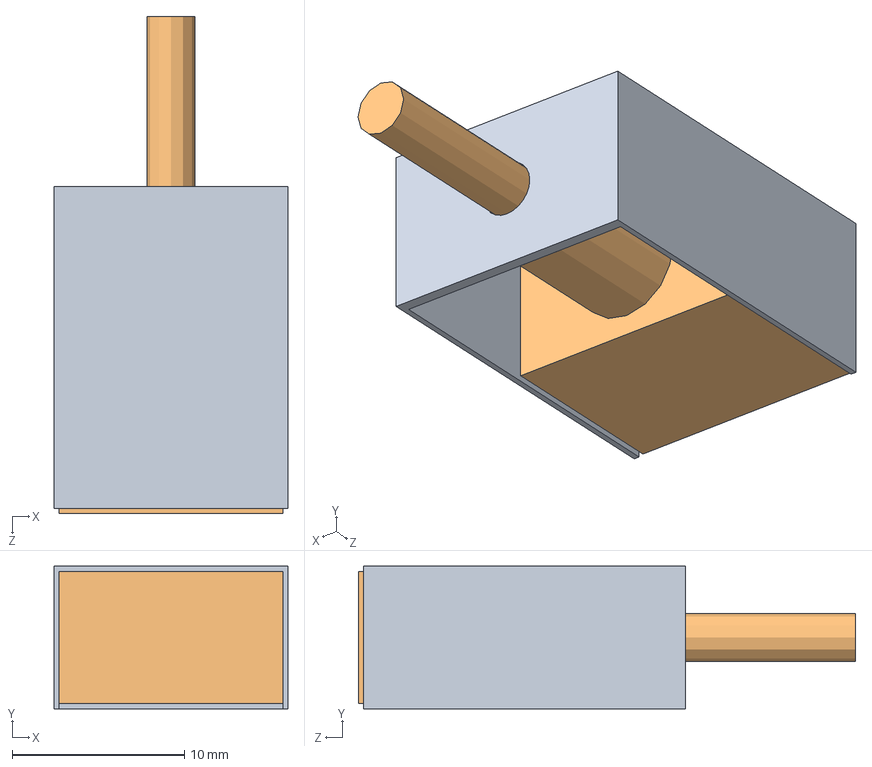
[picture p49: CAD file, 2023-05-09]
CAD/ControllerModule/MontCapa.SLDASM
13.6 x 8.30 x 28.9 mm
Capa switch
switch
