GabrielBarbosaUFSC/Projeto-Pendular/CAD/Estrutura/EstruLat.SLDPRT.SLDASM

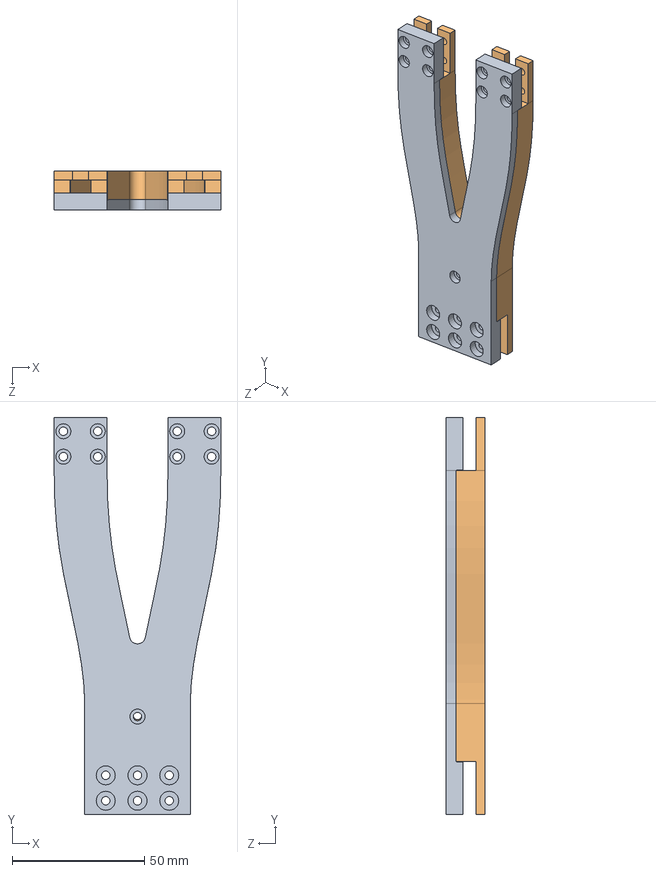
[picture p50: CAD file, 2023-05-13]
CAD/Estrutura/EstruLat.SLDPRT.SLDASM
63.0 x 150.0 x 14.9 mm
EstruturaLateral2a
EstruturaLateral2b
