GabrielBarbosaUFSC/Projeto-Pendular/Pendular/Montagem1.SLDASM

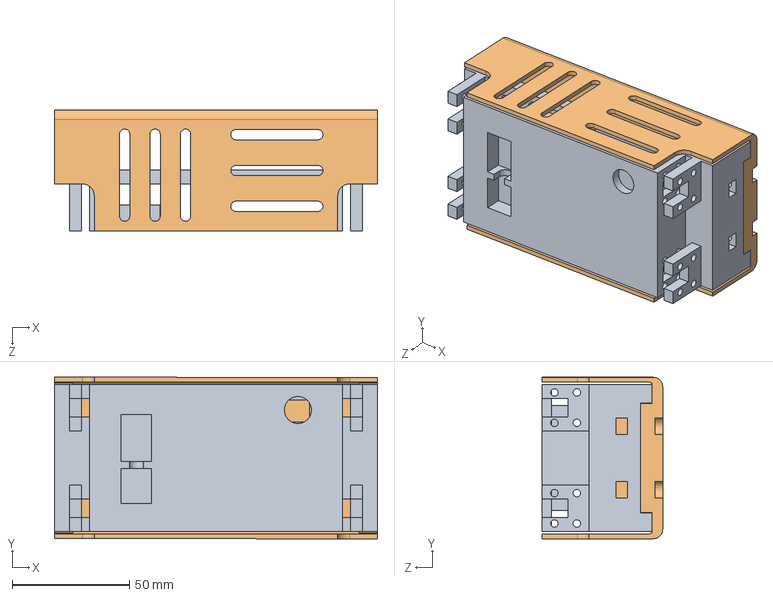
[picture p51: CAD file, 2024-09-13]
Pendular/Montagem1.SLDASM
138.0 x 69.0 x 51.5 mm
basecontroler
Topoo2
