GabrielBarbosaUFSC/Projeto-Pendular/CAD/BatteryModule/Base.SLDPRT

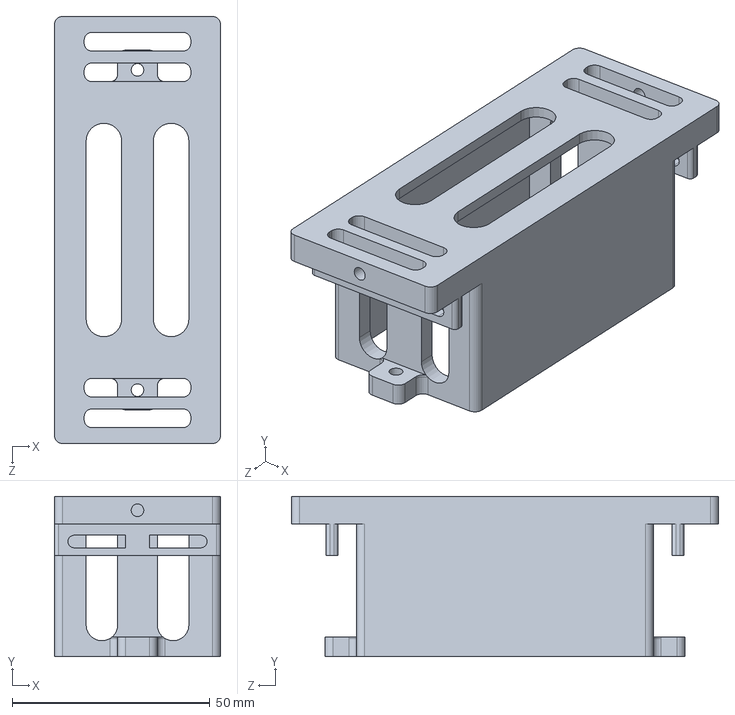
[picture p52: CAD file, 2023-06-13]
CAD/BatteryModule/Base.SLDPRT
42.0 x 40.5 x 108.0 mm
