GabrielBarbosaUFSC/Projeto-Pendular/CAD/CAD Final/Componentes/switch.SLDPRT

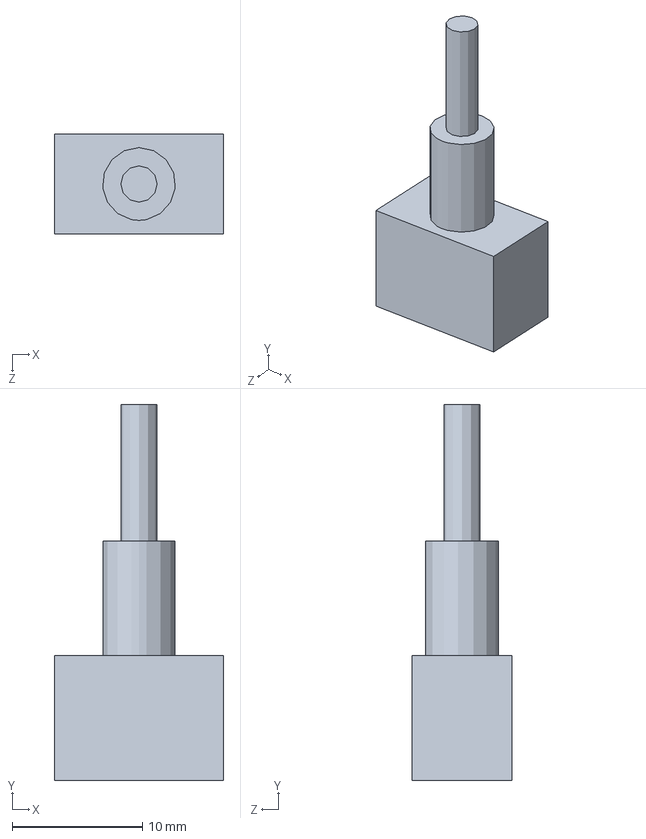
[picture p53: CAD file, 2023-08-23]
CAD/CAD Final/Componentes/switch.SLDPRT
13.0 x 28.9 x 7.70 mm
