GabrielBarbosaUFSC/Projeto-Pendular/CAD/CAD Final/Motores/motorsuportebase.SLDPRT

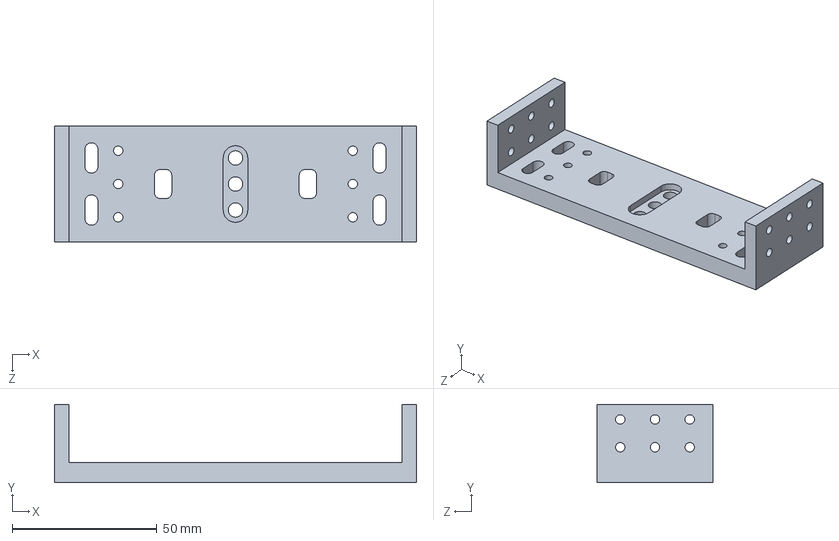
[picture p54: CAD file, 2023-08-23]
CAD/CAD Final/Motores/motorsuportebase.SLDPRT
125.0 x 27.0 x 40.0 mm
