GabrielBarbosaUFSC/Projeto-Pendular/CAD/CAD Final/Parafusos/15M3.SLDPRT

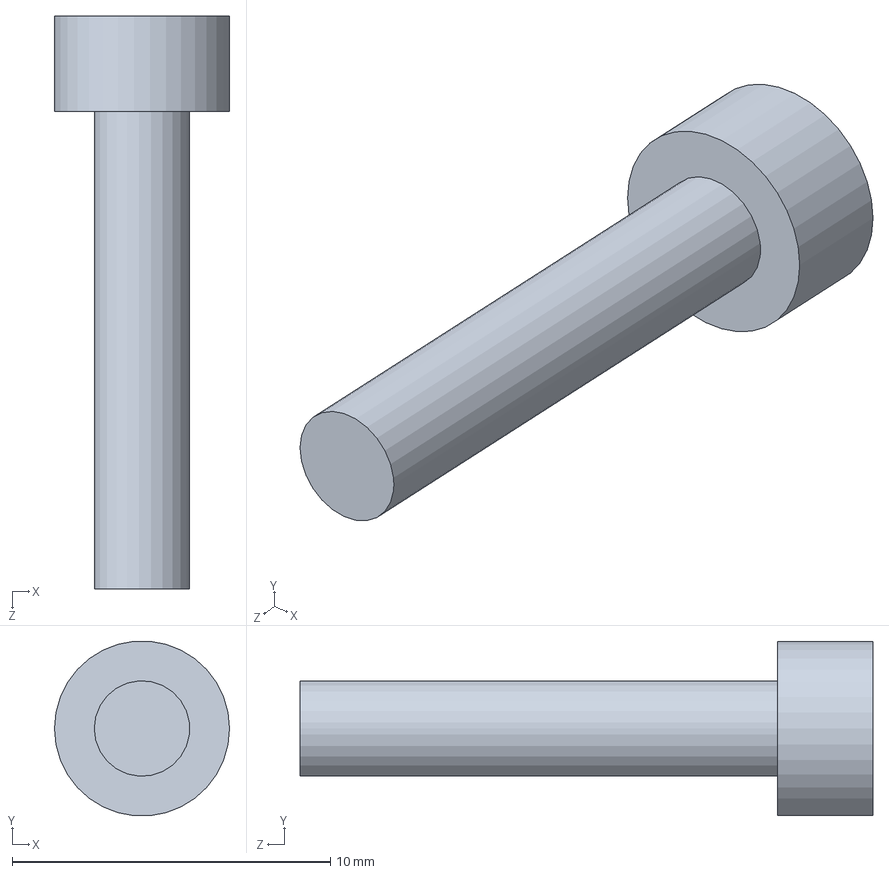
[picture p55: CAD file, 2023-08-23]
CAD/CAD Final/Parafusos/15M3.SLDPRT
5.50 x 5.48 x 18.0 mm
