GabrielBarbosaUFSC/Projeto-Pendular/CAD/CAD Final/Suporte Lateral/EstruturaLateral2a.SLDPRT

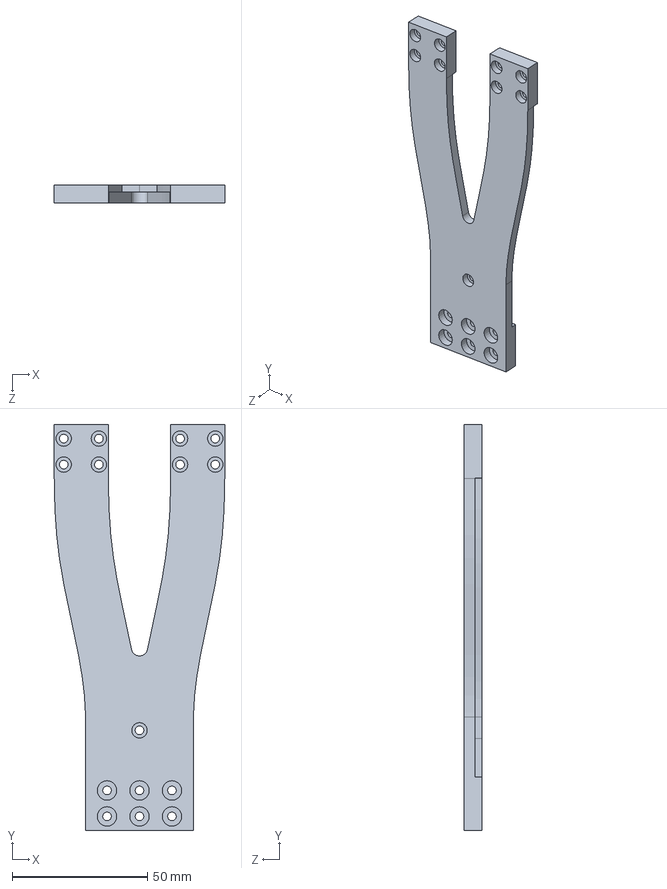
[picture p56: CAD file, 2023-08-23]
CAD/CAD Final/Suporte Lateral/EstruturaLateral2a.SLDPRT
63.0 x 150.0 x 6.50 mm
