GabrielBarbosaUFSC/Projeto-Pendular/CAD/ControllerModule/Topoo.SLDPRT

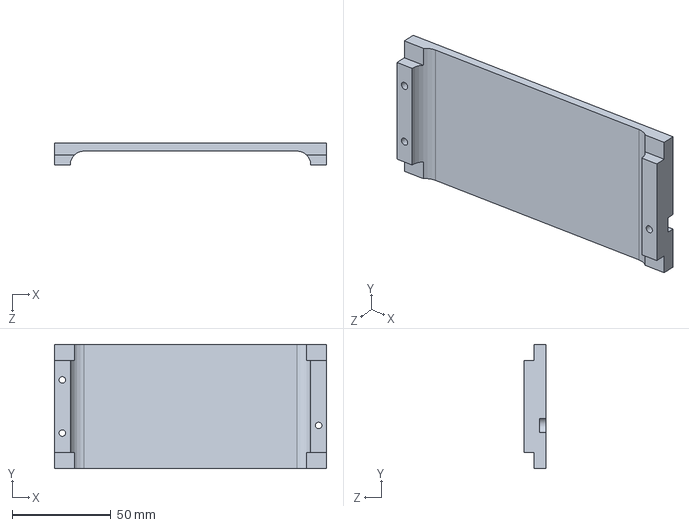
[picture p57: CAD file, 2023-08-02]
CAD/ControllerModule/Topoo.SLDPRT
138.0 x 63.0 x 11.0 mm
