GabrielBarbosaUFSC/Projeto-Pendular/CAD/Motor Module/acoplamento2.SLDPRT

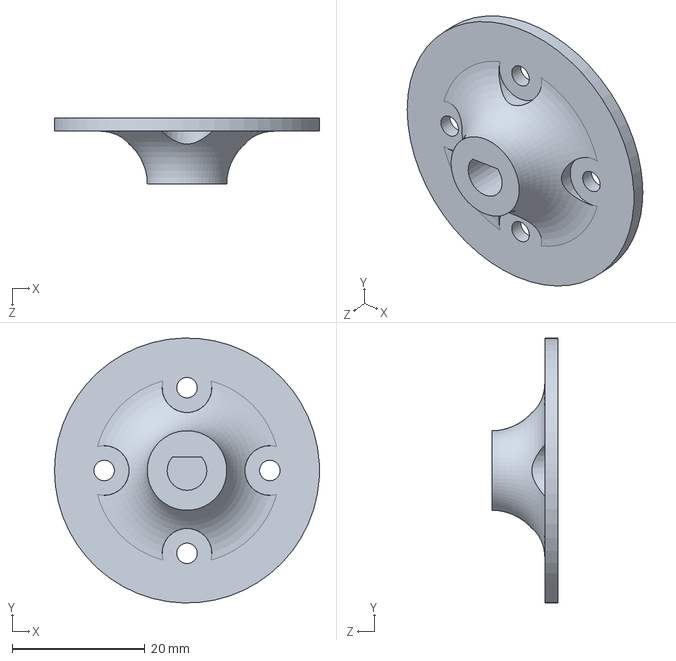
[picture p58: CAD file, 2023-08-11]
CAD/Motor Module/acoplamento2.SLDPRT
40.0 x 40.0 x 10.0 mm
