GabrielBarbosaUFSC/Projeto-Pendular/CAD/Motor Module/motormodule/motor_base.SLDPRT

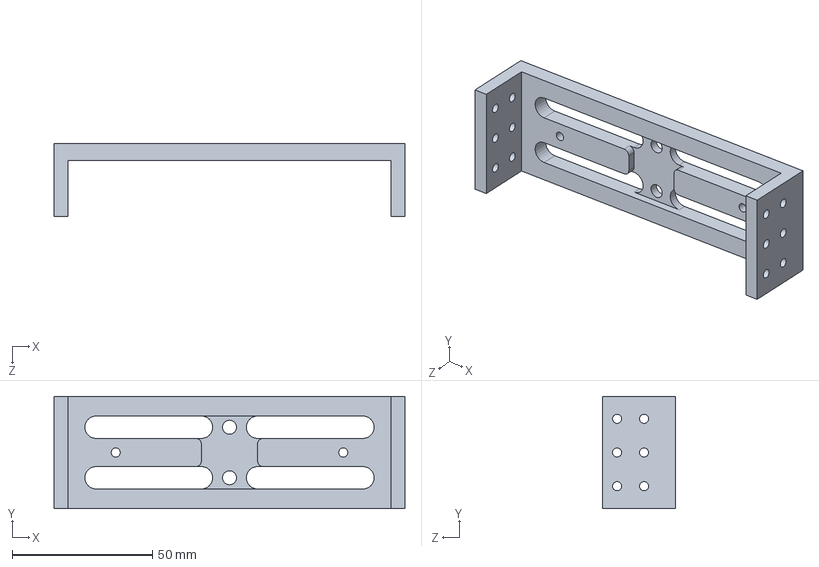
[picture p59: CAD file, 2023-06-04]
CAD/Motor Module/motormodule/motor_base.SLDPRT
125.0 x 40.0 x 26.0 mm
