GabrielBarbosaUFSC/Projeto-Pendular/CAD/Motor Torque 2/arruela3.SLDPRT

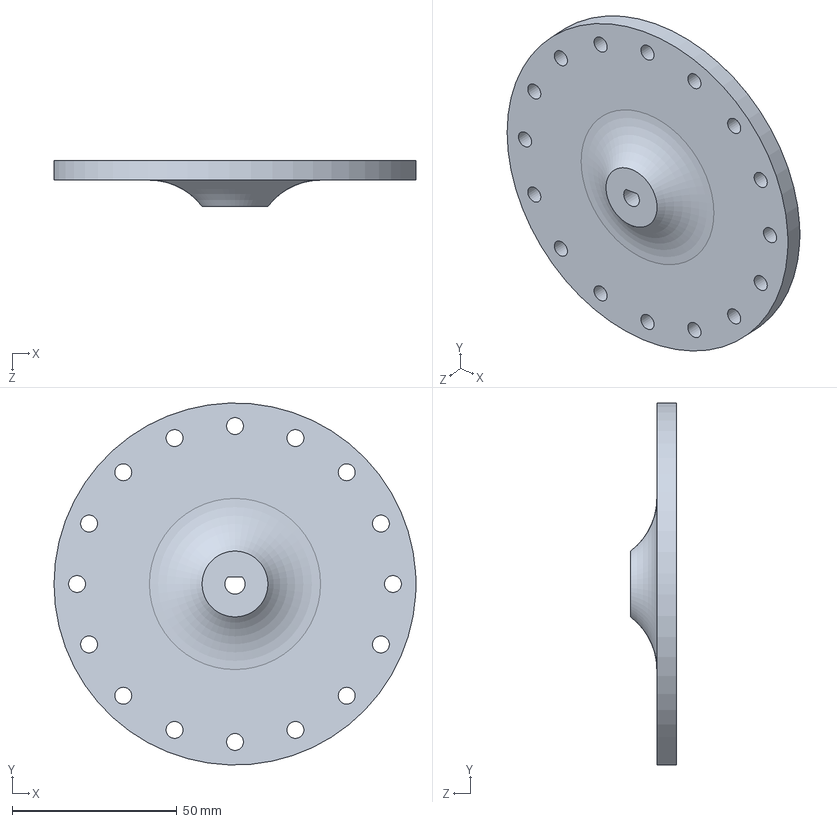
[picture p60: CAD file, 2023-07-24]
CAD/Motor Torque 2/arruela3.SLDPRT
110.0 x 110.0 x 14.0 mm
