GabrielBarbosaUFSC/Projeto-Pendular/CAD/Motor Torque/arruela2.SLDPRT

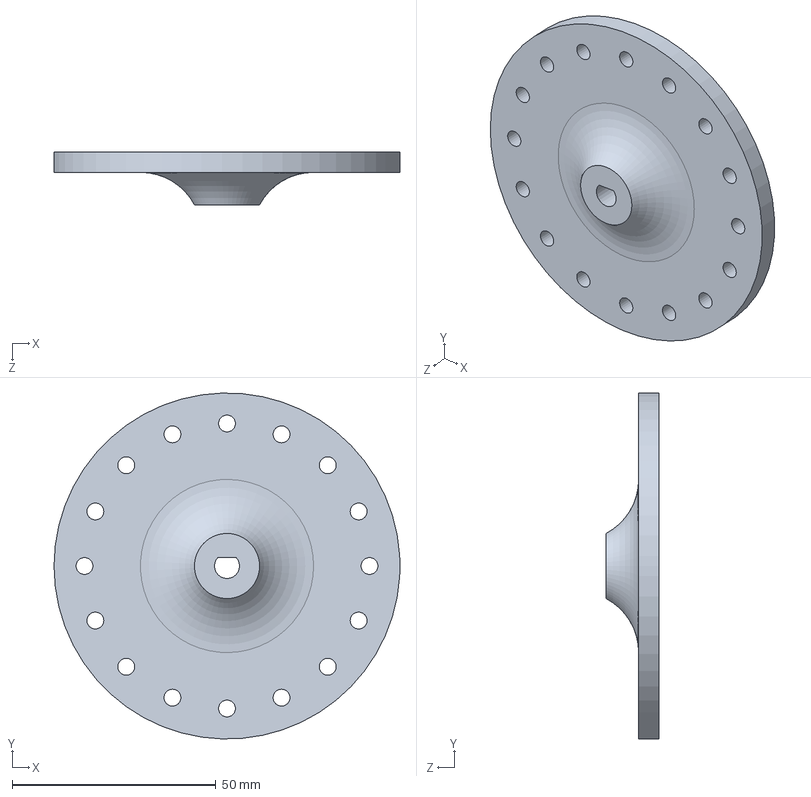
[picture p61: CAD file, 2023-07-24]
CAD/Motor Torque/arruela2.SLDPRT
85.0 x 85.0 x 13.0 mm
