GabrielBarbosaUFSC/Projeto-Pendular/CAD/Suporte Motor/juncao.SLDPRT

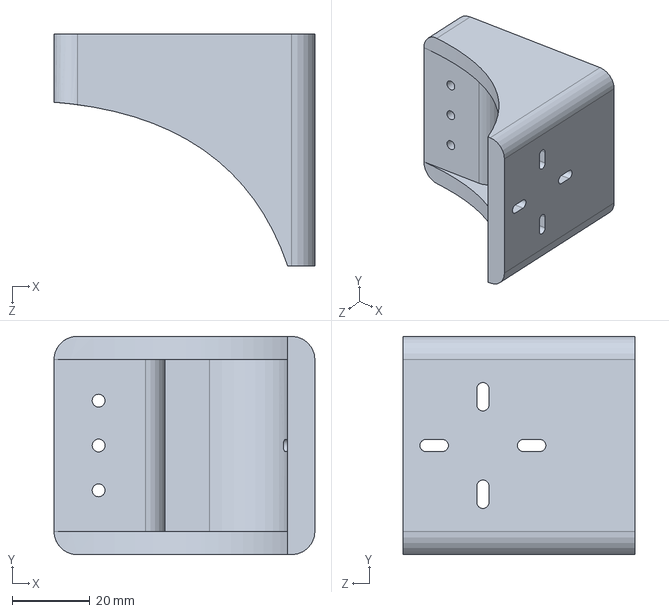
[picture p62: CAD file, 2023-07-24]
CAD/Suporte Motor/juncao.SLDPRT
66.9 x 56.0 x 59.5 mm
