GabrielBarbosaUFSC/Projeto-Pendular/CAD/Trava Motor 2/Trava.SLDPRT

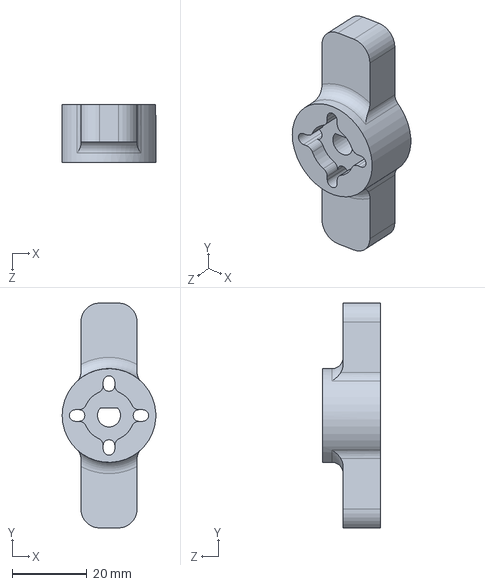
[picture p63: CAD file, 2023-07-18]
CAD/Trava Motor 2/Trava.SLDPRT
25.0 x 60.0 x 15.5 mm
