GabrielBarbosaUFSC/Projeto-Pendular/GabrielCAD/Estrutura/EstruturaLateral1.SLDPRT

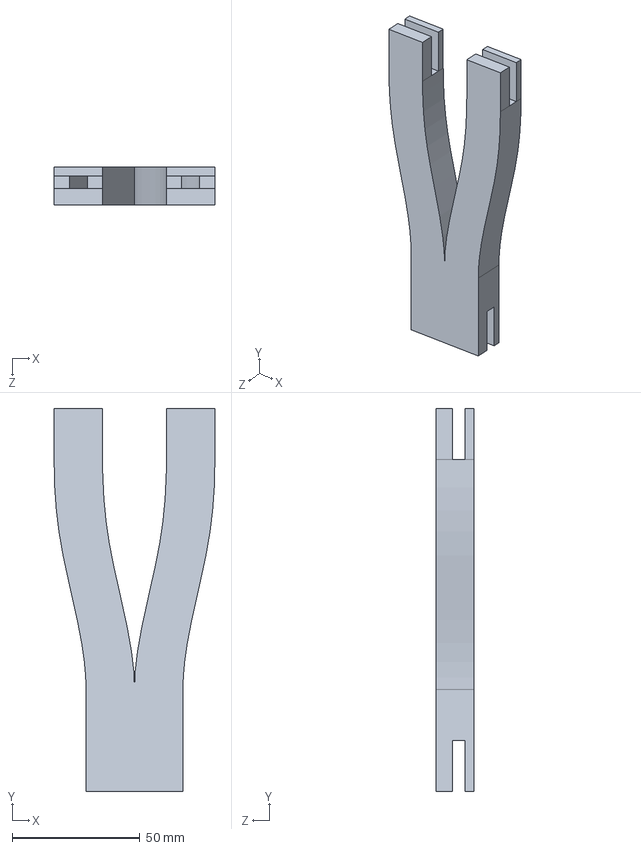
[picture p64: CAD file, 2023-05-04]
GabrielCAD/Estrutura/EstruturaLateral1.SLDPRT
63.0 x 150.0 x 15.0 mm
