GabrielBarbosaUFSC/Projeto-Pendular/Pendular/Support.STL

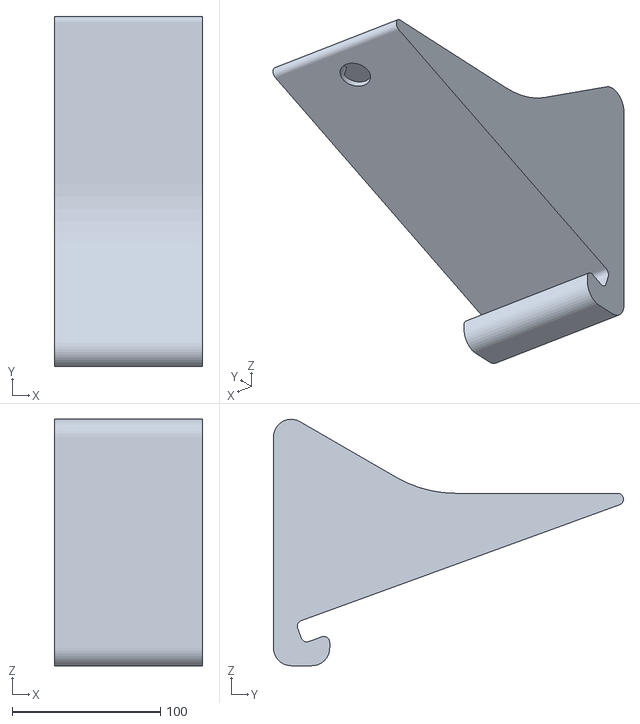
[picture p65: CAD file, 2024-09-13]
Pendular/Support.STL
100.0 x 236.3 x 166.4
