GabrielBarbosaUFSC/Projeto-Pendular/CAD/CAD Final/Bateria/Baterry.SLDPRT

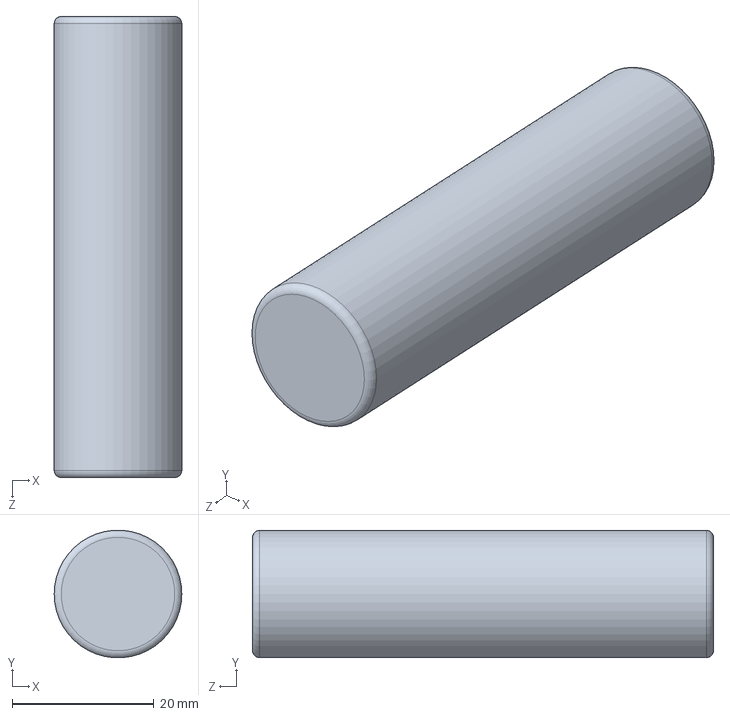
[picture p66: CAD file, 2023-08-23]
CAD/CAD Final/Bateria/Baterry.SLDPRT
18.0 x 18.0 x 65.0 mm
