GabrielBarbosaUFSC/Projeto-Pendular/CAD/CAD Final/Componentes/p4.SLDPRT

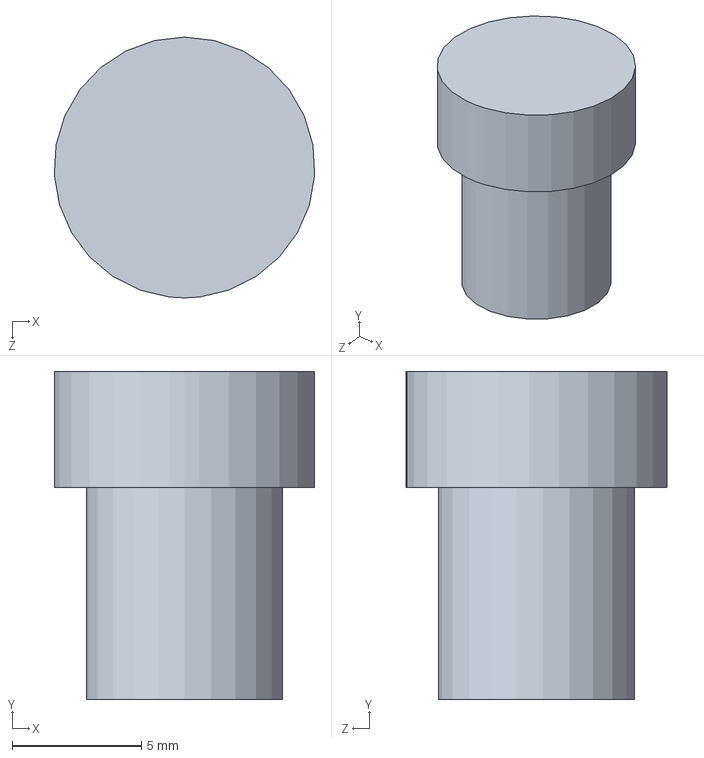
[picture p67: CAD file, 2023-08-23]
CAD/CAD Final/Componentes/p4.SLDPRT
10.1 x 12.7 x 10.1 mm
