GabrielBarbosaUFSC/Projeto-Pendular/CAD/CAD Final/Controlador/BaseControllers.SLDPRT

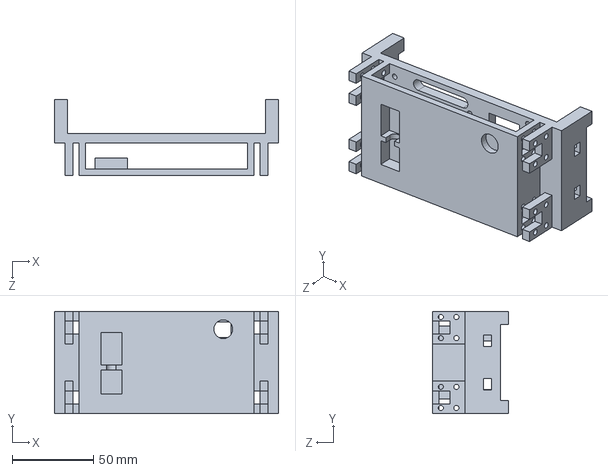
[picture p68: CAD file, 2023-08-23]
CAD/CAD Final/Controlador/BaseControllers.SLDPRT
138.0 x 63.0 x 47.0 mm
