GabrielBarbosaUFSC/Projeto-Pendular/CAD/CAD Final/Motores/motor.SLDPRT

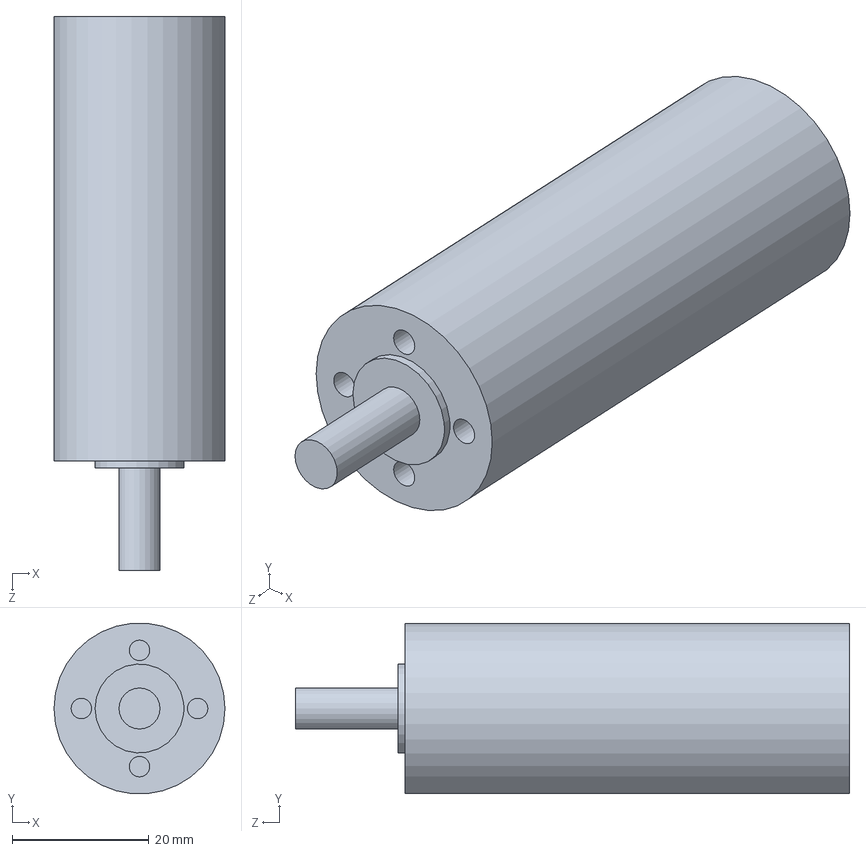
[picture p69: CAD file, 2023-08-23]
CAD/CAD Final/Motores/motor.SLDPRT
25.0 x 24.9 x 81.0 mm
