GabrielBarbosaUFSC/Projeto-Pendular/CAD/CAD Final/Parafusos/20M3.SLDPRT

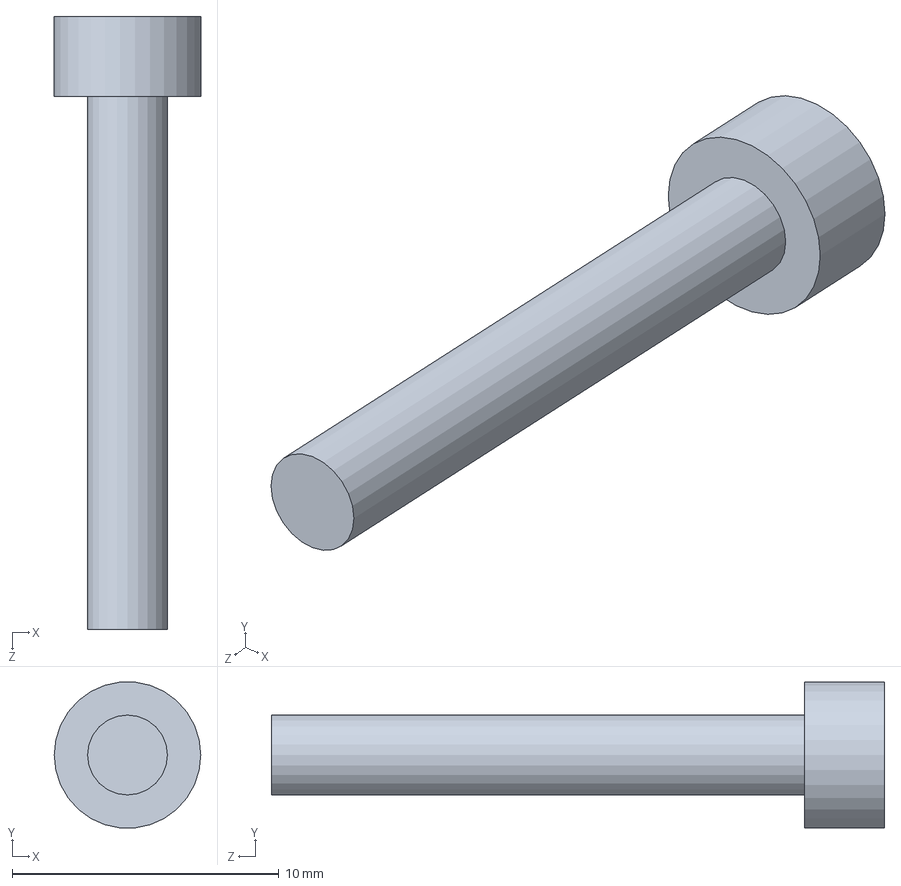
[picture p70: CAD file, 2023-08-23]
CAD/CAD Final/Parafusos/20M3.SLDPRT
5.50 x 5.47 x 23.0 mm
