GabrielBarbosaUFSC/Projeto-Pendular/CAD/CAD Final/Suporte Lateral/EstruturaLateral2b.SLDPRT

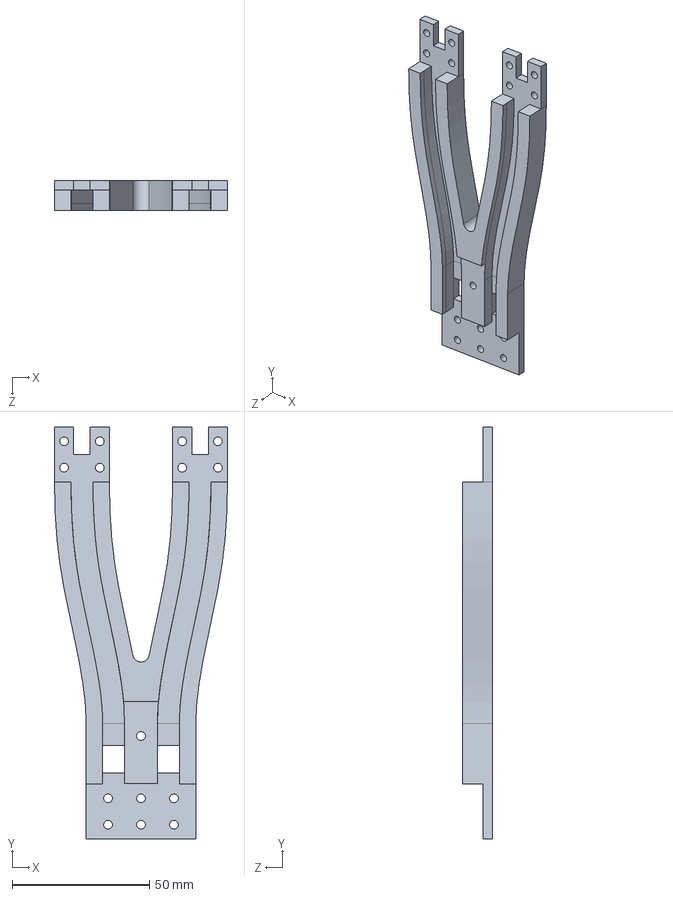
[picture p71: CAD file, 2023-08-23]
CAD/CAD Final/Suporte Lateral/EstruturaLateral2b.SLDPRT
63.0 x 150.0 x 11.0 mm
