GabrielBarbosaUFSC/Projeto-Pendular/CAD/Motor Module/Arruela2.SLDPRT

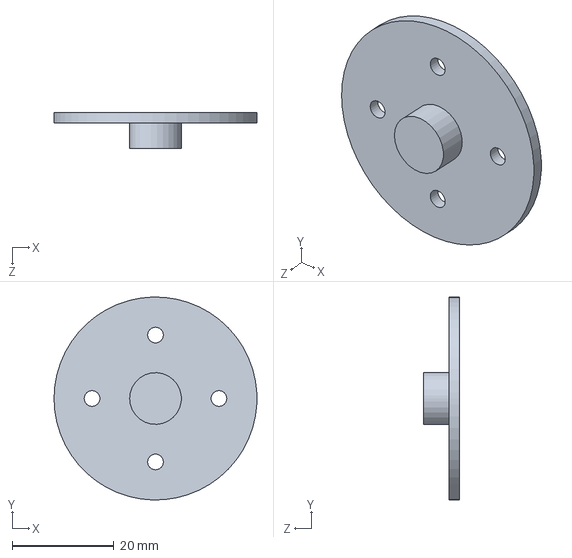
[picture p72: CAD file, 2023-06-13]
CAD/Motor Module/Arruela2.SLDPRT
40.0 x 40.0 x 7.00 mm
