GabrielBarbosaUFSC/Projeto-Pendular/CAD/Motor Torque 3/arruela4.SLDPRT

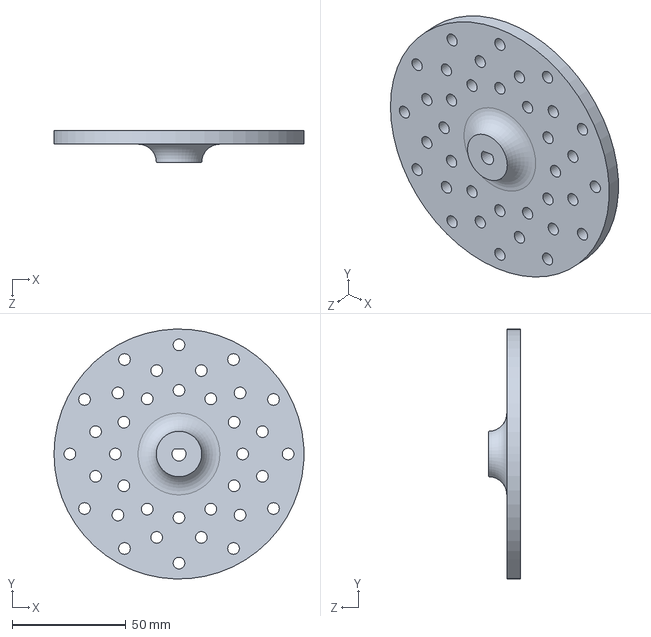
[picture p73: CAD file, 2023-07-24]
CAD/Motor Torque 3/arruela4.SLDPRT
110.0 x 110.0 x 14.0 mm
