GabrielBarbosaUFSC/Projeto-Pendular/GabrielCAD/Motor Module/motor_base.SLDPRT

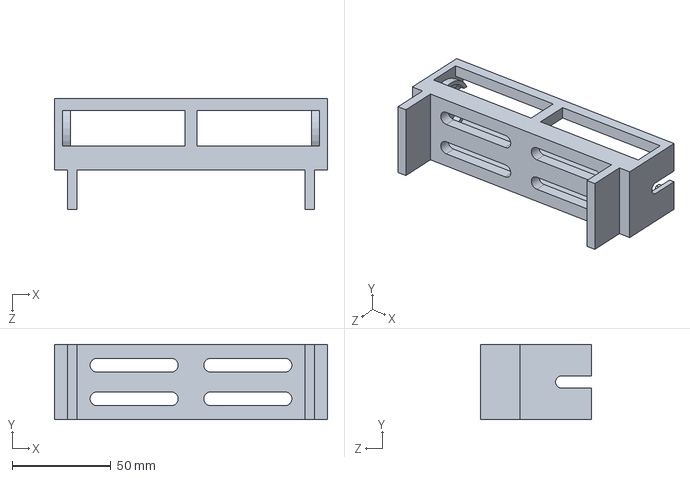
[picture p74: CAD file, 2023-05-04]
GabrielCAD/Motor Module/motor_base.SLDPRT
138.0 x 38.0 x 56.0 mm
