GabrielBarbosaUFSC/Projeto-Pendular/Pendular/Topoo2 Final.STL

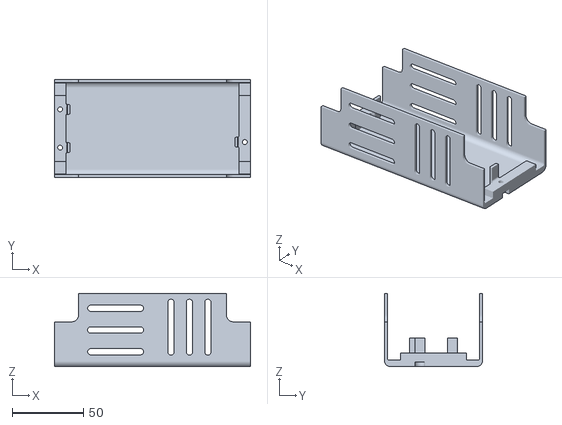
[picture p75: CAD file, 2024-09-13]
Pendular/Topoo2 Final.STL
138.0 x 69.0 x 51.5
