GabrielBarbosaUFSC/Projeto-Pendular/CAD/CAD Final/Componentes/button.SLDPRT

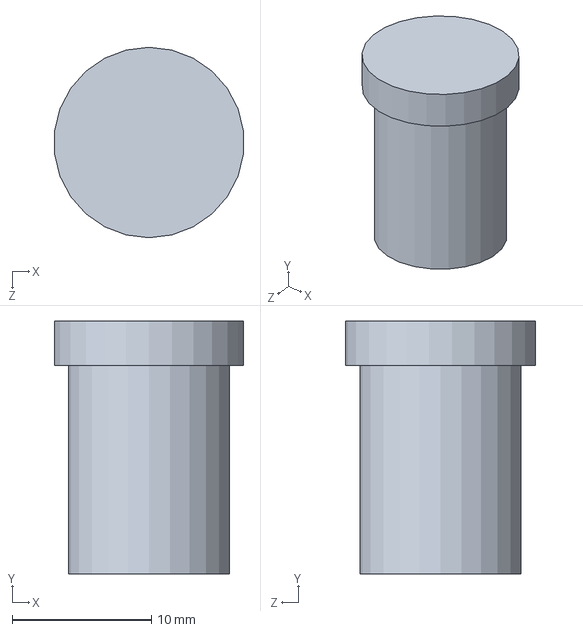
[picture p76: CAD file, 2023-08-23]
CAD/CAD Final/Componentes/button.SLDPRT
13.6 x 18.2 x 13.7 mm
