GabrielBarbosaUFSC/Projeto-Pendular/CAD/CAD Final/Motores/motorsuporte.SLDPRT

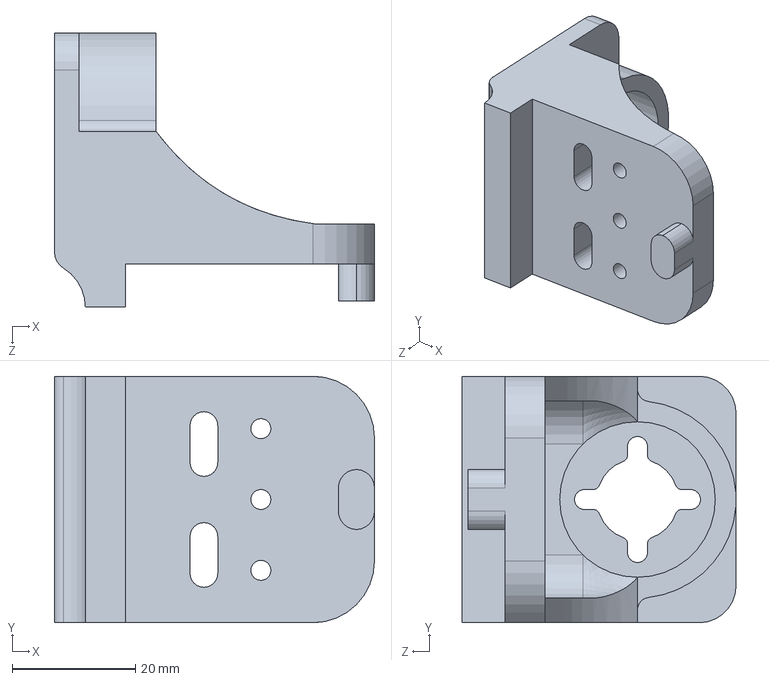
[picture p77: CAD file, 2023-08-23]
CAD/CAD Final/Motores/motorsuporte.SLDPRT
51.9 x 40.0 x 44.5 mm
