GabrielBarbosaUFSC/Projeto-Pendular/CAD/CAD Final/Parafusos/porca.SLDPRT

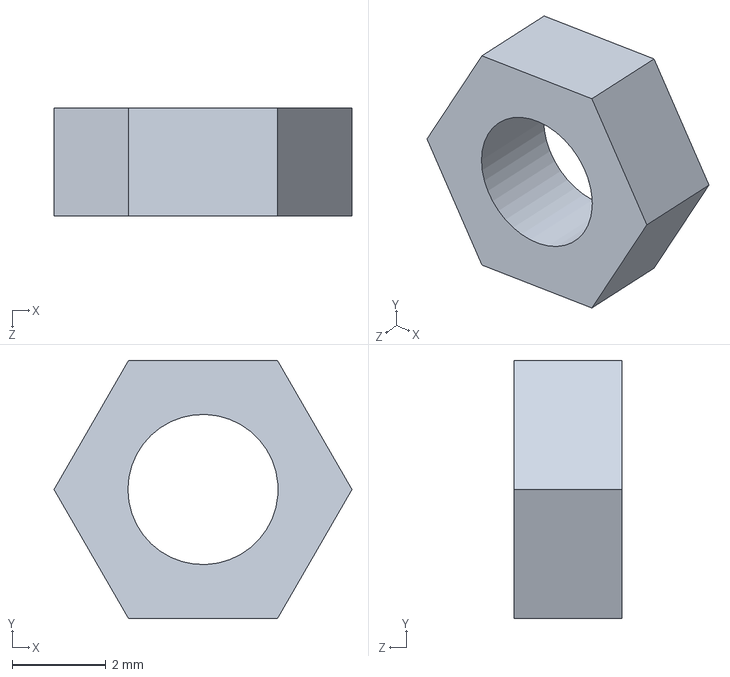
[picture p78: CAD file, 2023-08-23]
CAD/CAD Final/Parafusos/porca.SLDPRT
6.35 x 5.50 x 2.30 mm
