GabrielBarbosaUFSC/Projeto-Pendular/GabrielCAD/Motor Module/roda.SLDPRT

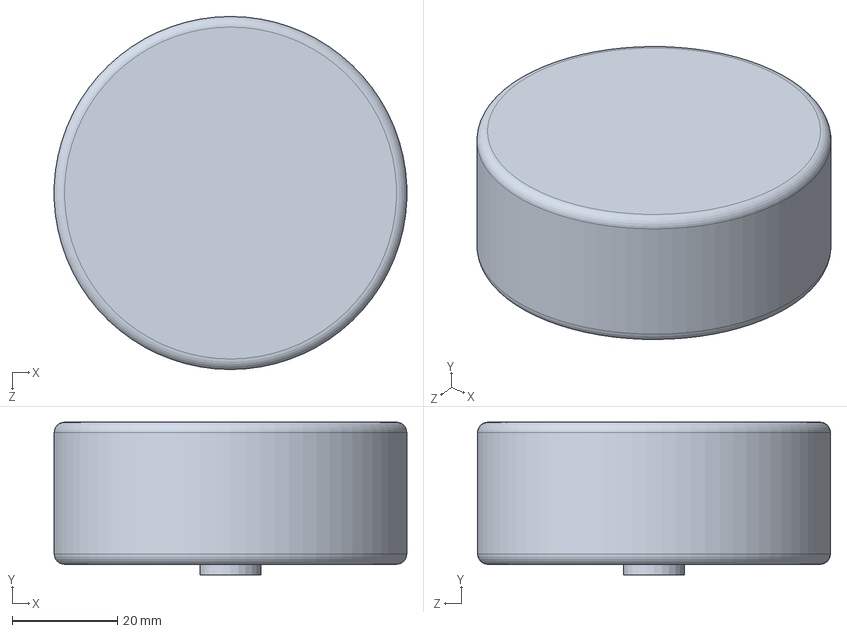
[picture p79: CAD file, 2023-05-04]
GabrielCAD/Motor Module/roda.SLDPRT
66.9 x 29.0 x 67.0 mm
