GabrielBarbosaUFSC/Projeto-Pendular/Pendular/Topoo2 with logo.SLDPRT

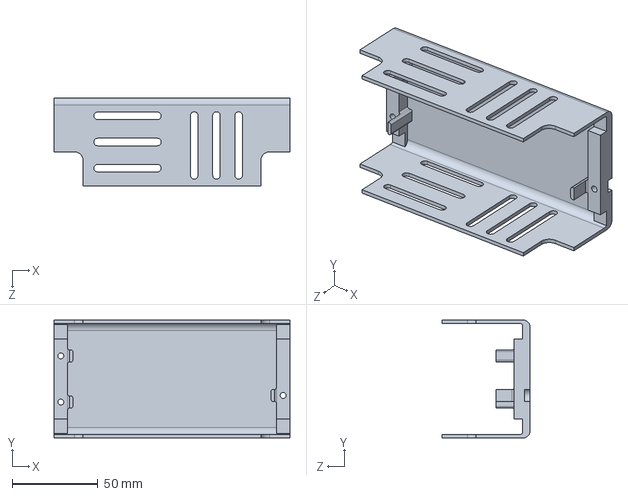
[picture p80: CAD file, 2024-09-13]
Pendular/Topoo2 with logo.SLDPRT
138.0 x 69.0 x 51.5 mm
