GabrielBarbosaUFSC/Projeto-Pendular/CAD/CAD Final/Componentes/LedsCtrl.SLDPRT

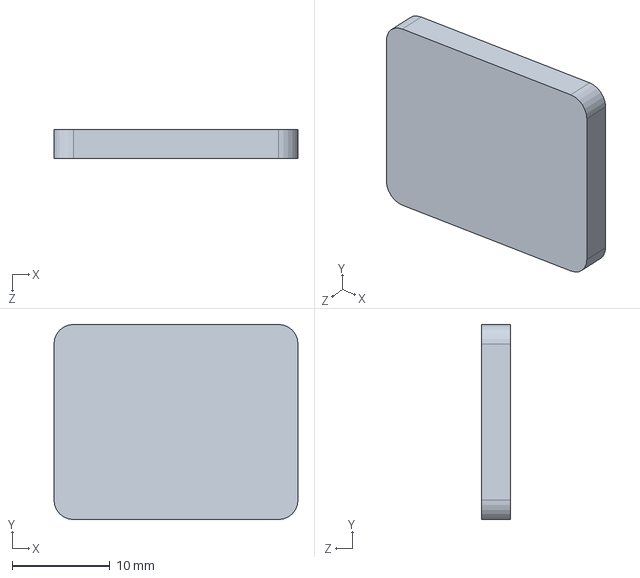
[picture p81: CAD file, 2023-08-23]
CAD/CAD Final/Componentes/LedsCtrl.SLDPRT
25.0 x 20.0 x 3.00 mm
