GabrielBarbosaUFSC/Projeto-Pendular/CAD/CAD Final/Parafusos/Arruela.SLDPRT

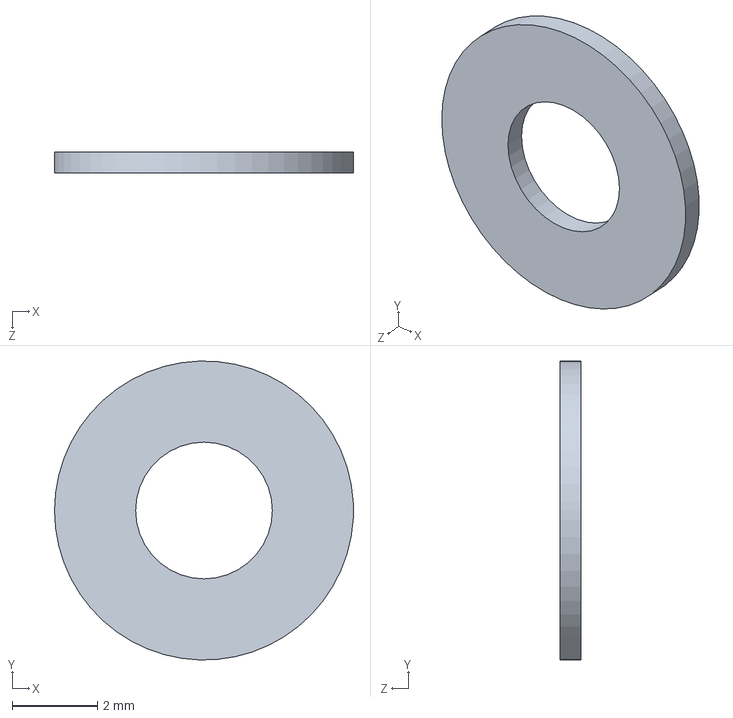
[picture p82: CAD file, 2023-08-23]
CAD/CAD Final/Parafusos/Arruela.SLDPRT
7.00 x 7.00 x 0.5 mm
