GabrielBarbosaUFSC/Projeto-Pendular/CAD/Motor Module/motor_base.SLDPRT

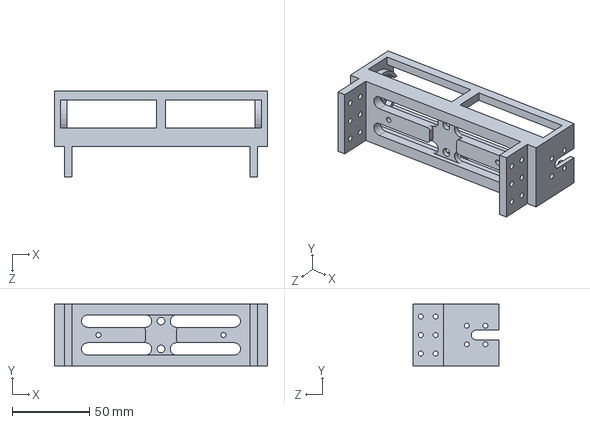
[picture p83: CAD file, 2023-05-30]
CAD/Motor Module/motor_base.SLDPRT
138.0 x 40.0 x 56.0 mm
