GabrielBarbosaUFSC/Projeto-Pendular/GabrielCAD/Motor Module/motor.SLDPRT

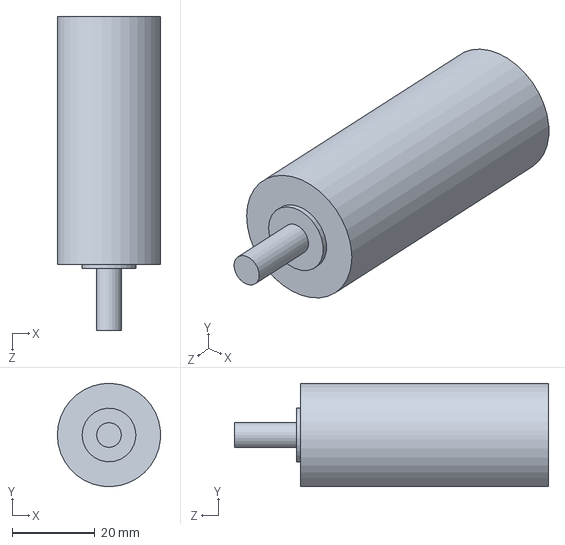
[picture p84: CAD file, 2023-05-04]
GabrielCAD/Motor Module/motor.SLDPRT
25.0 x 25.0 x 76.0 mm
