GabrielBarbosaUFSC/Projeto-Pendular/CAD/CAD Final/Componentes/LM2596.SLDPRT

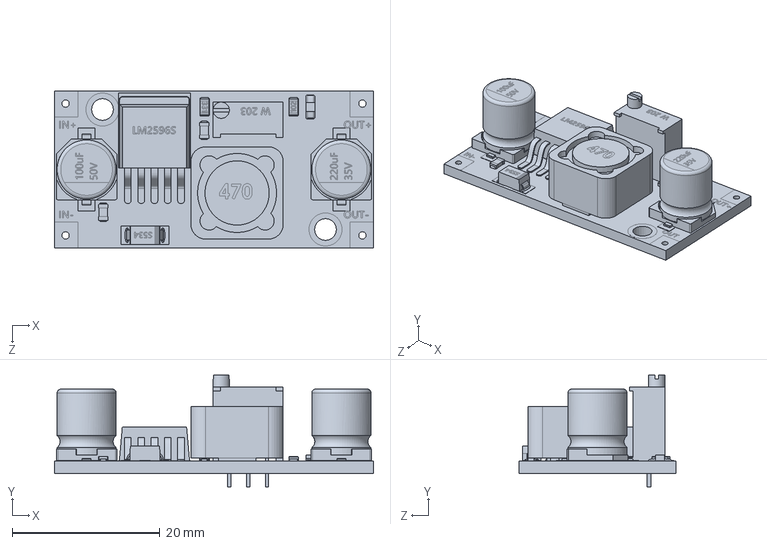
[picture p85: CAD file, 2023-08-23]
CAD/CAD Final/Componentes/LM2596.SLDPRT
43.2 x 15.1 x 21.2 mm
