GabrielBarbosaUFSC/Projeto-Pendular/CAD/CAD Final/Motores/roda.SLDPRT

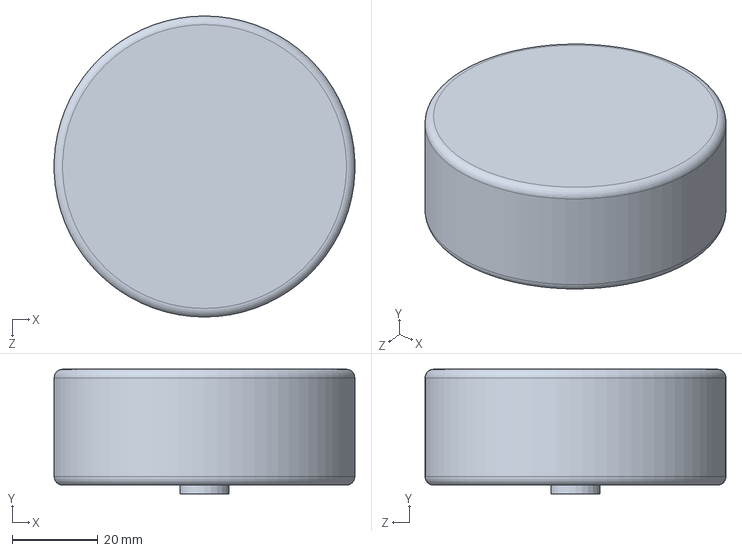
[picture p86: CAD file, 2023-08-23]
CAD/CAD Final/Motores/roda.SLDPRT
69.9 x 29.0 x 70.0 mm
