GabrielBarbosaUFSC/Projeto-Pendular/CAD/CAD Final/Parafusos/8M3.SLDPRT

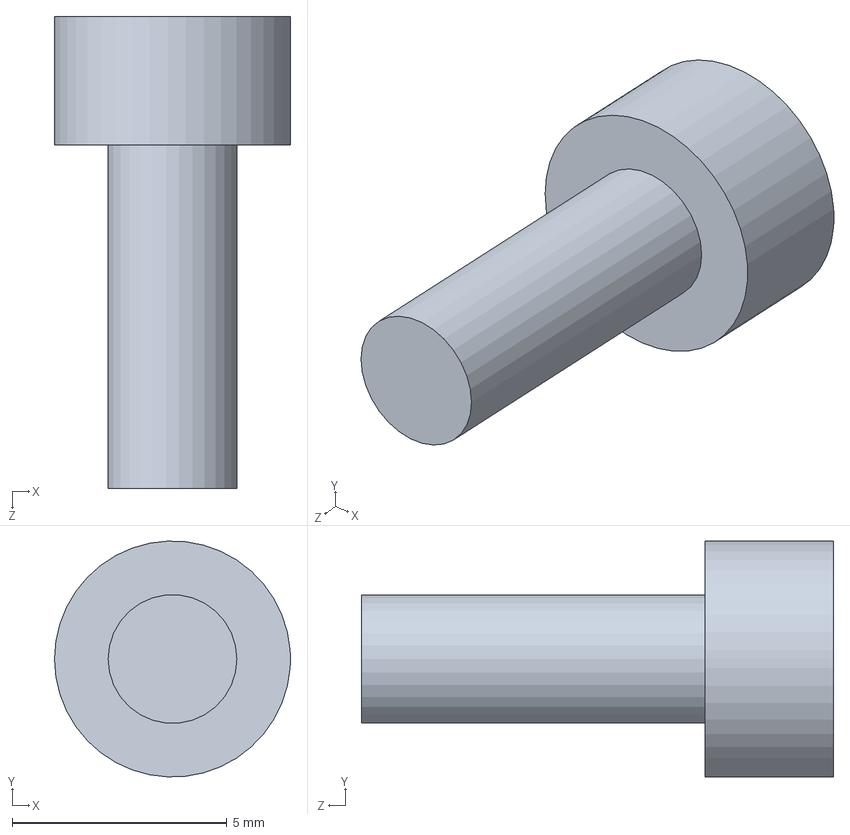
[picture p87: CAD file, 2023-08-23]
CAD/CAD Final/Parafusos/8M3.SLDPRT
5.50 x 5.50 x 11.0 mm
