GabrielBarbosaUFSC/Projeto-Pendular/CAD/ControllerModule/SwitchCase.SLDPRT

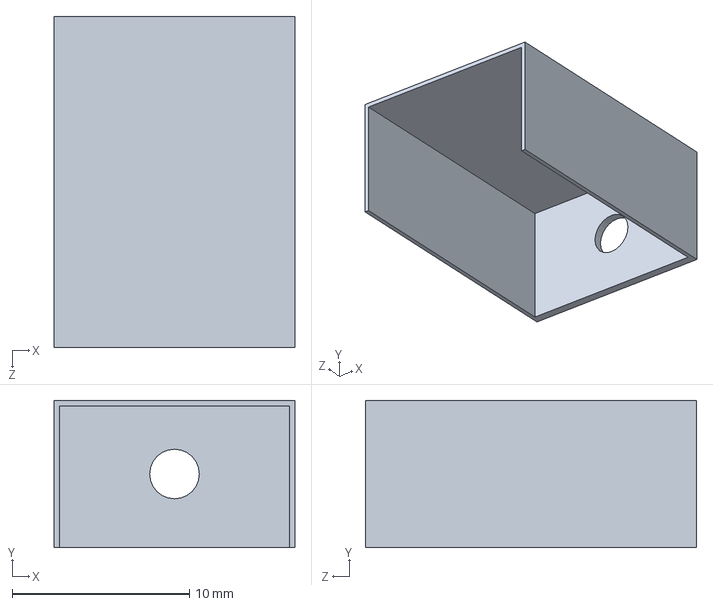
[picture p88: CAD file, 2023-05-09]
CAD/ControllerModule/SwitchCase.SLDPRT
13.6 x 8.30 x 18.7 mm
