GabrielBarbosaUFSC/Projeto-Pendular/CAD/CAD Final/Componentes/MPU9250.SLDPRT

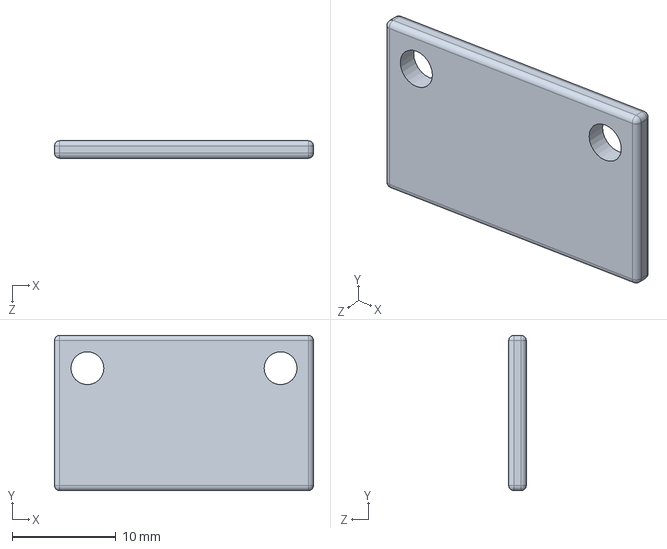
[picture p89: CAD file, 2023-08-23]
CAD/CAD Final/Componentes/MPU9250.SLDPRT
25.0 x 15.0 x 1.70 mm
