GabrielBarbosaUFSC/Projeto-Pendular/CAD/CAD Final/Componentes/esp_uno.SLDPRT

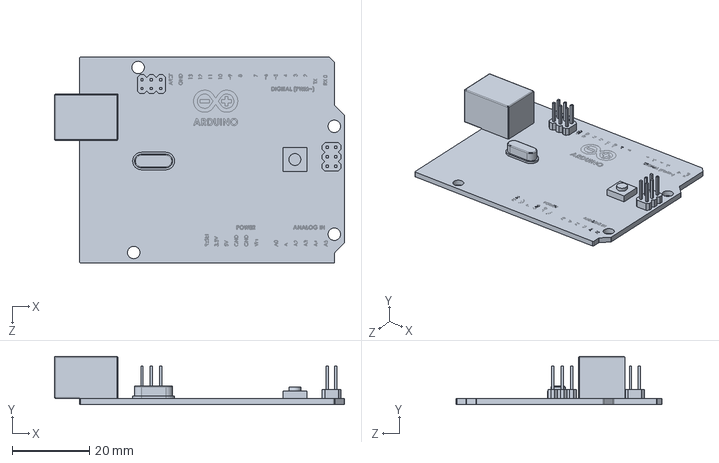
[picture p90: CAD file, 2023-08-23]
CAD/CAD Final/Componentes/esp_uno.SLDPRT
75.1 x 12.5 x 53.3 mm
