GabrielBarbosaUFSC/Projeto-Pendular/Pendular/logo.stl

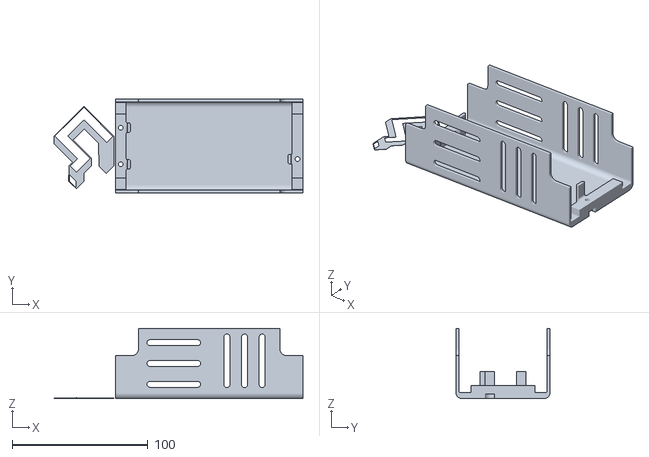
[picture p91: CAD file, 2024-09-13]
Pendular/logo.stl
183.1 x 69.0 x 51.5
