GabrielBarbosaUFSC/Projeto-Pendular/CAD/CAD Final/Componentes/BMS.SLDPRT

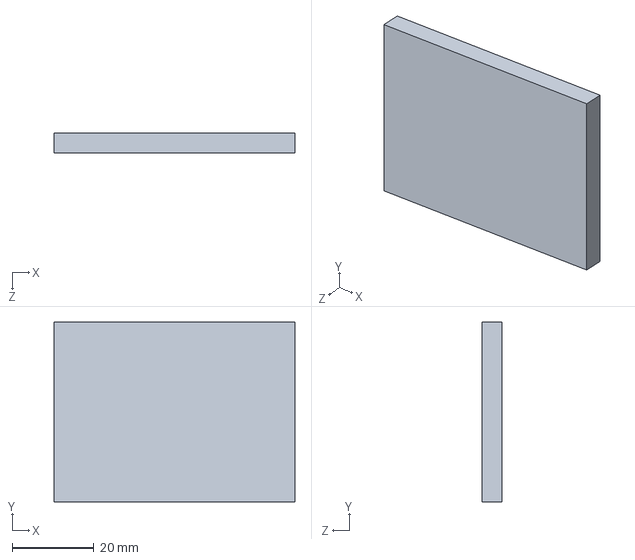
[picture p92: CAD file, 2023-08-23]
CAD/CAD Final/Componentes/BMS.SLDPRT
59.0 x 44.0 x 5.00 mm
