GabrielBarbosaUFSC/Projeto-Pendular/CAD/CAD Final/Componentes/divisor.SLDPRT

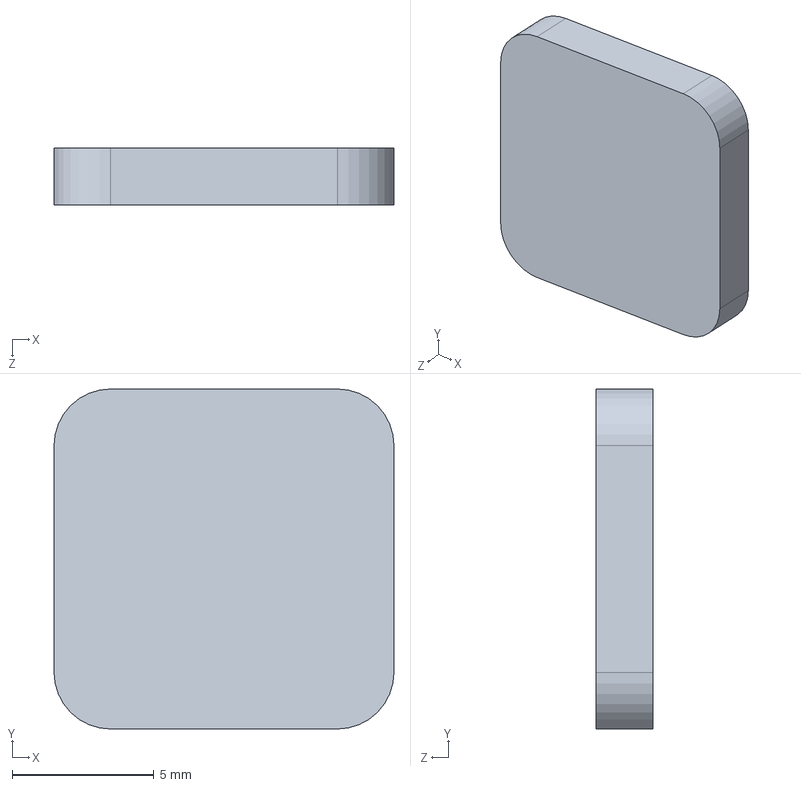
[picture p93: CAD file, 2023-08-23]
CAD/CAD Final/Componentes/divisor.SLDPRT
12.0 x 12.0 x 2.00 mm
