GabrielBarbosaUFSC/Projeto-Pendular/(list of files, cad)

Other CAD files:
CAD/Estrutura/EstruturaLateral1.SLDPRT
CAD/Motor Torque 3/arruela.SLDPRT
CAD/Estrutura/EstruturaLateral2b.SLDPRT
CAD/Motor Torque 2/arruela.SLDPRT
CAD/Motor Torque/arruela.SLDPRT
CAD/BatteryModule/Baterry.SLDPRT
CAD/CAD Final/Bateria/Base.SLDPRT
CAD/ControllerModule/BaseControllers.SLDPRT
CAD/Estrutura/EstruturaLateral2a.SLDPRT
CAD/Suporte Motor/motorsuporte.SLDPRT
CAD/Suporte Motor/motorsuportebase.SLDPRT
CAD/Motor Module/roda.SLDPRT
CAD/Suporte Motor/motor.SLDPRT
Pendular/basecontroler.SLDPRT
Pendular/Topoo2.SLDPRT
CAD/CAD Final/Pendular.SLDDRW
CAD/Components/MPU9250.SLDPRT
CAD/Components/p4.SLDPRT
CAD/Parafusos/20M3.SLDPRT
CAD/Parafusos/Arruela.SLDPRT
CAD/Parafusos/porca.SLDPRT
GabrielCAD/BatteryModule/Base.SLDPRT
GabrielCAD/BatteryModule/Baterry.SLDPRT
Pendular/Topoo2 with logo.STL
