GabrielBarbosaUFSC/Projeto-Pendular/Modelagem do Processo/Controle Preditivo/TestnThetaU1/test.txt

// date: 2023-08-21 09:52:17

// n_rows: 2
// n_colu: 3
// n_elem: 6

double A[6] = {
	1.0000000000000000e+00, 2.0000000000000000e+00, 3.0000000000000000e+00, 
	4.0000000000000000e+00, 5.0000000000000000e+00, 6.0000000000000000e+00
};

// n_rows: 3
// n_colu: 2
// n_elem: 6

double B[6] = {
	7.0000000000000000e+00, 8.0000000000000000e+00, 
	9.0000000000000000e+00, 1.0000000000000000e+01, 
	1.1000000000000000e+01, 1.2000000000000000e+01
};
