GabrielBarbosaUFSC/Projeto-Pendular/SoftwareEmbarcado/Pendular/scripts/calibrationadc/data.csv

PWM | ADC
0 | 0.000000
5 | 0.000000
10 | 0.000000
15 | 0.000000
20 | 0.000000
25 | 0.000000
30 | 0.000000
35 | 0.000000
40 | 0.000000
45 | 0.000000
50 | 0.000000
55 | 0.000000
60 | 0.000000
65 | 0.000000
70 | 0.000000
75 | 0.000000
80 | 0.000000
85 | 0.000000
90 | 0.000000
95 | 0.000000
100 | 0.000000
105 | 0.000000
110 | 0.000000
115 | 0.000000
120 | 0.000000
125 | 0.000000
130 | 0.000000
135 | 0.000000
140 | 0.000000
145 | 0.000000
150 | 0.040000
155 | 0.070000
160 | 0.220000
165 | 0.790000
170 | 2.780000
175 | 5.690000
180 | 10.480000
185 | 14.450000
190 | 19.220000
195 | 23.710000
200 | 29.660000
205 | 36.100000
210 | 42.320000
215 | 45.620000
220 | 47.200000
225 | 52.240000
230 | 57.180000
235 | 62.120000
240 | 65.690000
245 | 70.140000
250 | 74.140000
255 | 81.210000
260 | 82.010000
265 | 89.420000
270 | 93.530000
275 | 102.990000
280 | 106.030000
285 | 110.320000
290 | 111.710000
295 | 120.460000
300 | 122.510000
305 | 130.810000
310 | 130.430000
315 | 140.910000
320 | 137.720000
325 | 147.670000
330 | 149.880000
335 | 159.180000
340 | 161.850000
345 | 165.020000
350 | 169.660000
355 | 177.370000
360 | 177.480000
365 | 187.250000
370 | 188.790000
375 | 197.340000
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
