GabrielBarbosaUFSC/Projeto-Pendular/(threads)

Thread 16 (2023-06-07):

Suporte Controladores

GabrielBarbosaUFSC, 2023-06-07:
- Refazer todo o conjunto e repensar para que seja mais fácil de ser impressa.
- Encaixe do Arduino/Esp foi malfeito
- Encaixe do acelerômetro também foi malfeito.
- Furo para a passagem de fios da chave.
- Parafusos com o suporte lateral ficaram rentes ao suporte, é necessário que repense esse posicionamento.
- Adicionar suportes para o acabamento.
- A chave ficou muito justa, é necessário aumentar a folga.

GabrielBarbosaUFSC, 2023-06-07:
Adicionar suportes para acabamento = orelhinhas para parafusar as capas, para fins estéticos

GabrielBarbosaUFSC, 2023-06-26:
Melhorar o conjunto do suporte do switch

GabrielBarbosaUFSC, 2023-08-27:
Adicionar proteção contra quedas

Thread 24 (2023-08-01):

Eletrônica

GabrielBarbosaUFSC, 2023-08-01:
Planejar um PCB para os componentes
Tensão residual no Amp Op

GabrielBarbosaUFSC, 2023-08-27:
Adicionar um potenciômetro digital (ou conversor DAQ) para permitir a calibração dos sensores na PCB
Adicionar pontos (de alta impedância) para medição de tensão em diferentes partes
Adicionar medição de corrente
Diminuir a quantidade de baterias e ajustar o BMS para tal

GabrielBarbosaUFSC, 2023-08-27:
Usar o MPU 6050 (deixar duas unidades) no topo
