GabrielBarbosaUFSC/Projeto-Pendular/(commit log)

2023-05-08 Revert "Gabriel branch"
    [Arduino_rn.SLDPRT, Base.SLDPRT, BaseControllers.SLDPRT, Baterry.SLDPRT, BatteryModule.SLDASM, EstruturaLateral1.SLDPRT, MotorModule.SLDASM, Pendular2.SLDASM]
2023-05-08 add chave
    [chave.SLDPRT]
2023-05-08 add arduino, botao, chave e p4
    [LM2596.SLDASM, arduino_uno.SLDPRT, botao.SLDPRT, p4.SLDPRT]
2023-05-09 modified: AnaliseDados/calibrationadc/calibrationadc.ipynb
2023-05-13 add lib example
    [20M3.SLDPRT, Arruela.SLDPRT, Base.SLDPRT, BaseControllers.SLDPRT, EstruLat.SLDPRT.SLDASM, EstruturaLateral1.SLDPRT, EstruturaLateral2a.SLDPRT, EstruturaLateral2b.SLDPRT]
2023-05-18 Adição da Lib Wire
2023-05-18 sem erros de copilação
2023-05-18 novo modo de chamar função
2023-05-19 Add files via upload
    Cecilia e Mateus, Led rgb piscando
2023-05-22 duda calibration
2023-05-25 add julia
    [Base.SLDPRT, BatteryModule.SLDASM, MPU9250.SLDPRT, MontTop.SLDASM, MotorModule.SLDASM, Pendular2.SLDASM, motor_base.SLDPRT]
2023-05-27 add calibration routine
    [data.csv]
2023-05-29 add motor cad
    [MotorModule.SLDASM, Pendular2.SLDASM, motor_base.SLDPRT]
2023-05-30 add CAD motor base
    [MotorModule.SLDASM, Pendular2.SLDASM, motor.SLDPRT, motor_base.SLDPRT]
2023-05-30 update cad base controller
    [BaseControllers.SLDPRT, MontTop.SLDASM, Pendular2.SLDASM]
2023-05-31 Pasta e código para teste encoder motores
2023-06-01 modified: CAD/Motor Module/motor_base.SLDPRT
    [motor_base.SLDPRT]
2023-06-04 update CAD
    [Base.SLDPRT, BatteryModule.SLDASM, MontSuppMotor.SLDASM, MotorModule.SLDASM, Pendular2.SLDASM, motor.SLDPRT, motor_base.SLDPRT, motorsuporte.SLDPRT]
2023-06-06 add motor test
2023-06-08 fix adccalibration
    [34_1.csv, 34_2.csv, 34_3.csv, 35_1.csv, 35_2.csv, 35_3.csv, 36_1.csv, 36_2.csv]
2023-06-09 terminada lib para teste com sensor
2023-06-13 add motor3
    [Arruela2.SLDPRT, Base.SLDPRT, BatteryModule.SLDASM, acoplamento2.SLDPRT]
2023-06-20 Programa de Pulsos encoder
2023-06-20 data motor
    [motor.csv]
2023-06-21 processing motor data
2023-07-19 motor data
    [M1.csv, M2.csv, M3.csv]
2023-08-02 commit all
    [MontTop.SLDASM, Topoo.SLDPRT]
2023-08-03 get inertial data
    [15M3.SLDPRT, 20M3.SLDPRT, 8M3.SLDPRT, Arruela.SLDPRT, BMS.SLDPRT, Base.SLDPRT, BaseControllers.SLDPRT, Baterry.SLDPRT]
2023-08-23 works code
    [15M3.SLDPRT, 20M3.SLDPRT, 8M3.SLDPRT, Arruela.SLDPRT, BMS.SLDPRT, Base.SLDPRT, BaseControllers.SLDPRT, Baterry.SLDPRT]
2024-09-13 new file: Novo(a) Documento de Texto.txt new file: Pendular/Diff/Ax0.mat new file: Pendular/Diff/Malha Externa/project.m new file: Pendular/Diff/Malha Interna/project.m new file: Pendular/Diff/bx0.ma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
    [Montagem1.SLDASM, Support.STL, Topoo2 Final.STL, Topoo2 with logo.SLDPRT, Topoo2 with logo.STL, Topoo2.SLDPRT, basecontroler.SLDPRT, logo.stl]
